danylipsker/HIGH-RATIO-GEAR-SET/output/ratio-500_m1_planet32/design_report.md

# Gear set design report - target ratio 500:1

Generated by `gearset.py --ratio 500 --planet 32 --aw-max 32 --delta-max 5 --ecc-min 8 --max-wall 20 --out /home/user/high-ratio-gear-set/output/ratio-500_m1_planet32`

## Result

| | |
|---|---|
| Exact ratio input : output | **-500** (output turns opposite to the input) |
| Module | 1.0 mm |
| Pressure angle | 20.0 deg |
| Sun Zs (input) | 20 |
| Planet Zp (one planet, on a free carrier) | 32 |
| Thin ring, internal teeth Zr1 | 135 |
| Thin ring, external teeth Zr2 | 153 |
| Fixed ring Zf (housing) | 204 (x = +0.0000) |
| Output ring Zo | 200 (x = +2.5097) |
| Profile-shifted ring | output ring, working pressure angle 30.00 deg |
| Sun-planet centre distance a1 | 26.0000 mm |
| Thin ring eccentricity e (centre at x = -e) | 25.5000 mm |
| Thin ring wall between tooth roots | 6.500 mm |
| Ring outer diameter | 217.52 mm |
| Face width per section / gap / total length | 10.0 / 2.0 / 22.0 mm (+ shaft stubs) |
| Backlash per mesh | 0.0 mm |

## How the ratio arises

All centres are fixed in the carrier frame, so Willis' method applies mesh by mesh:

```
carrier speed      wc = ws * Zs*Zr2 / (Zf*Zr1 + Zs*Zr2)
thin ring speed    wt = wc * (Zr2 - Zf) / Zr2          (rolls inside the fixed ring)
output ring speed  wo = wc * (Zo - Zf) / Zo
ratio              i  = ws / wo = Zo*(Zf*Zr1 + Zs*Zr2) / (Zs*Zr2*(Zo - Zf))
                      = 200*(204*135 + 20*153) / (20*153*(200 - 204)) = -500
```
The fixed ring is required: without a grounded ring the mechanism has two degrees of freedom and the
output ring would not be driven. The output ring differs from the fixed ring by 4 teeth and meshes with the same external teeth of the thin ring, which is why it is profile shifted.

Independent numeric check (pitch-point velocities in the fixed frame, sun speed = 1):

```
   carrier:  0.100000000
    planet: -0.462500000
 thin_ring: -0.033333333
    output: -0.002000000
     ratio: -500.000000000
formula   : -500.000000000   difference 6.82e-13
```
## Geometry of every toothed outline (mm)

| gear | type | Z | x | reference r | base rb | tip ra | root rf | root fillet | first tooth centre (deg) |
|---|---|---|---|---|---|---|---|---|---|
| sun | external | 20 | +0.0000 | 10.0000 | 9.3969 | 11.0000 | 8.7500 | 0.300 | 0.0000 |
| planet | external | 32 | +0.0000 | 16.0000 | 15.0351 | 17.0000 | 14.7500 | 0.240 | 5.6250 |
| thin_ring_internal | internal | 135 | +0.0000 | 67.5000 | 63.4293 | 66.5000 | 68.7500 | 0.300 | 0.0000 |
| thin_ring_external | external | 153 | +0.0000 | 76.5000 | 71.8865 | 77.5000 | 75.2500 | 0.300 | 0.0000 |
| fixed_ring | internal | 204 | +0.0000 | 102.0000 | 95.8486 | 101.0000 | 103.2500 | 0.300 | 0.0000 |
| output_ring | internal | 200 | +2.5097 | 100.0000 | 93.9693 | 101.5097 | 103.7597 | 0.240 | 1.8000 |

Positions in the assembly (mm): sun at (0,0), planet at (26.0000, 0), thin ring centre at (-25.5000, 0), fixed and output rings concentric with the sun. The sun/planet/thin-ring meshes lie on the +x axis, the thin-ring/fixed-ring and thin-ring/output-ring meshes on the -x axis. The outlines are already rotated (phases above) so that all teeth mesh at these positions.

## Mesh checks

| mesh | transverse contact ratio |
|---|---|
| sun/planet | 1.612 |
| planet/thin ring internal | 1.888 |
| thin ring external/fixed ring | 1.977 |
| thin ring external/output ring | 1.124 |

Radial clearances on the line of centres: fixed ring tip/thin ring root 0.250 mm, fixed ring root/thin ring tip 0.250 mm, output ring tip/thin ring root 0.760 mm, output ring root/thin ring tip 0.760 mm.

Rolling check (every gear rotated through two sun pitches in the carrier frame, worst penetration of
one tooth outline into the mating one; negative = minimum clearance, positive = collision):

| mesh | worst penetration (mm) |
|---|---|
| sun/planet | -0.0001 |
| planet/thin ring internal | +0.0003 |
| thin ring external/fixed ring | +0.0004 |
| thin ring external/output ring | +0.0001 |

## Axial layout

```
z = 0 .. 10   section A : sun, planet, thin ring internal teeth, FIXED ring
z = 12 .. 22   section B : carrier journal (in the thin ring bore), OUTPUT ring
thin ring external teeth run the full length 0 .. 22
carrier journal radius 68.650 centred at (-25.500, 0), bore for the sun shaft at (0,0), planet pin at (26.000, 0)
```
## Other exact solutions found

| score | Zs | Zp | Zr1 | Zr2 | Zf | Zo | shifted | alpha_w | ratio | ring OD at this module |
|---|---|---|---|---|---|---|---|---|---|---|
| 24.6 | 20 | 32 | 135 | 153 | 204 | 200 | output | 30.0 | -500 | 221.5 |

Re-run with `--set Zs Zp Zr1 Zr2 Zf Zo` to build any row, or `--sun/--planet` to pin tooth counts.
