danylipsker/HIGH-RATIO-GEAR-SET/output/ratio-500_m1_sun16/design_report.md

# Gear set design report - target ratio 500:1

Generated by `gearset.py --ratio 500 --sun 16 --out /home/user/high-ratio-gear-set/output/ratio-500_m1_sun16`

## Result

| | |
|---|---|
| Exact ratio input : output | **-500** (output turns opposite to the input) |
| Module | 1.0 mm |
| Pressure angle | 20.0 deg |
| Sun Zs (input) | 16 |
| Planet Zp (one planet, on a free carrier) | 18 |
| Thin ring, internal teeth Zr1 | 96 |
| Thin ring, external teeth Zr2 | 123 |
| Fixed ring Zf (housing) | 167 (x = +0.0000) |
| Output ring Zo | 164 (x = +1.8376) |
| Profile-shifted ring | output ring, working pressure angle 28.88 deg |
| Sun-planet centre distance a1 | 17.0000 mm |
| Thin ring eccentricity e (centre at x = -e) | 22.0000 mm |
| Thin ring wall between tooth roots | 11.000 mm |
| Ring outer diameter | 180.18 mm |
| Face width per section / gap / total length | 10.0 / 2.0 / 22.0 mm (+ shaft stubs) |
| Backlash per mesh | 0.0 mm |

## How the ratio arises

All centres are fixed in the carrier frame, so Willis' method applies mesh by mesh:

```
carrier speed      wc = ws * Zs*Zr2 / (Zf*Zr1 + Zs*Zr2)
thin ring speed    wt = wc * (Zr2 - Zf) / Zr2          (rolls inside the fixed ring)
output ring speed  wo = wc * (Zo - Zf) / Zo
ratio              i  = ws / wo = Zo*(Zf*Zr1 + Zs*Zr2) / (Zs*Zr2*(Zo - Zf))
                      = 164*(167*96 + 16*123) / (16*123*(164 - 167)) = -500
```
The fixed ring is required: without a grounded ring the mechanism has two degrees of freedom and the
output ring would not be driven. The output ring differs from the fixed ring by 3 teeth and meshes with the same external teeth of the thin ring, which is why it is profile shifted.

Independent numeric check (pitch-point velocities in the fixed frame, sun speed = 1):

```
   carrier:  0.109333333
    planet: -0.682370370
 thin_ring: -0.039111111
    output: -0.002000000
     ratio: -500.000000000
formula   : -500.000000000   difference 5.12e-13
```
## Geometry of every toothed outline (mm)

| gear | type | Z | x | reference r | base rb | tip ra | root rf | root fillet | first tooth centre (deg) |
|---|---|---|---|---|---|---|---|---|---|
| sun | external | 16 | +0.0000 | 8.0000 | 7.5175 | 9.0000 | 6.7500 | 0.300 | 0.0000 |
| planet | external | 18 | +0.0000 | 9.0000 | 8.4572 | 10.0000 | 7.7500 | 0.300 | 10.0000 |
| thin_ring_internal | internal | 96 | +0.0000 | 48.0000 | 45.1052 | 47.0862 | 49.2500 | 0.300 | 0.0000 |
| thin_ring_external | external | 123 | +0.0000 | 61.5000 | 57.7911 | 62.5000 | 60.2500 | 0.300 | 0.0000 |
| fixed_ring | internal | 167 | +0.0000 | 83.5000 | 78.4643 | 82.5000 | 84.7500 | 0.300 | 1.0778 |
| output_ring | internal | 164 | +1.8376 | 82.0000 | 77.0548 | 82.8376 | 85.0876 | 0.300 | 2.1951 |

Positions in the assembly (mm): sun at (0,0), planet at (17.0000, 0), thin ring centre at (-22.0000, 0), fixed and output rings concentric with the sun. The sun/planet/thin-ring meshes lie on the +x axis, the thin-ring/fixed-ring and thin-ring/output-ring meshes on the -x axis. The outlines are already rotated (phases above) so that all teeth mesh at these positions.

## Mesh checks

| mesh | transverse contact ratio |
|---|---|
| sun/planet | 1.514 |
| planet/thin ring internal | 1.748 |
| thin ring external/fixed ring | 1.977 |
| thin ring external/output ring | 1.361 |

Radial clearances on the line of centres: fixed ring tip/thin ring root 0.250 mm, fixed ring root/thin ring tip 0.250 mm, output ring tip/thin ring root 0.588 mm, output ring root/thin ring tip 0.588 mm.

Rolling check (every gear rotated through two sun pitches in the carrier frame, worst penetration of
one tooth outline into the mating one; negative = minimum clearance, positive = collision):

| mesh | worst penetration (mm) |
|---|---|
| sun/planet | -0.0000 |
| planet/thin ring internal | +0.0004 |
| thin ring external/fixed ring | +0.0005 |
| thin ring external/output ring | +0.0002 |

**Warnings**

- thin_ring_internal: tip shortened by 0.086 mm - it reached 0.036 mm past the base-tangent point of the planet (involute interference); contact ratio recomputed with the shorter tip

## Axial layout

```
z = 0 .. 10   section A : sun, planet, thin ring internal teeth, FIXED ring
z = 12 .. 22   section B : carrier journal (in the thin ring bore), OUTPUT ring
thin ring external teeth run the full length 0 .. 22
carrier journal radius 49.150 centred at (-22.000, 0), bore for the sun shaft at (0,0), planet pin at (17.000, 0)
```
## Other exact solutions found

| score | Zs | Zp | Zr1 | Zr2 | Zf | Zo | shifted | alpha_w | ratio | ring OD at this module |
|---|---|---|---|---|---|---|---|---|---|---|
| 18.1 | 16 | 18 | 96 | 123 | 167 | 164 | output | 28.9 | -500 | 183.2 |

Re-run with `--set Zs Zp Zr1 Zr2 Zf Zo` to build any row, or `--sun/--planet` to pin tooth counts.
