danylipsker/HIGH-RATIO-GEAR-SET/output/ratio-500_m1/design_report.md

# Gear set design report - target ratio 500:1

Generated by `gearset.py --ratio 500 --out /home/user/high-ratio-gear-set/output/ratio-500_m1`

## Result

| | |
|---|---|
| Exact ratio input : output | **-500** (output turns opposite to the input) |
| Module | 1.0 mm |
| Pressure angle | 20.0 deg |
| Sun Zs (input) | 24 |
| Planet Zp (one planet, on a free carrier) | 20 |
| Thin ring, internal teeth Zr1 | 102 |
| Thin ring, external teeth Zr2 | 114 |
| Fixed ring Zf (housing) | 152 (x = +0.0000) |
| Output ring Zo | 150 (x = +1.1782) |
| Profile-shifted ring | output ring, working pressure angle 27.10 deg |
| Sun-planet centre distance a1 | 22.0000 mm |
| Thin ring eccentricity e (centre at x = -e) | 19.0000 mm |
| Thin ring wall between tooth roots | 3.500 mm |
| Ring outer diameter | 164.86 mm |
| Face width per section / gap / total length | 10.0 / 2.0 / 22.0 mm (+ shaft stubs) |
| Backlash per mesh | 0.0 mm |

## How the ratio arises

All centres are fixed in the carrier frame, so Willis' method applies mesh by mesh:

```
carrier speed      wc = ws * Zs*Zr2 / (Zf*Zr1 + Zs*Zr2)
thin ring speed    wt = wc * (Zr2 - Zf) / Zr2          (rolls inside the fixed ring)
output ring speed  wo = wc * (Zo - Zf) / Zo
ratio              i  = ws / wo = Zo*(Zf*Zr1 + Zs*Zr2) / (Zs*Zr2*(Zo - Zf))
                      = 150*(152*102 + 24*114) / (24*114*(150 - 152)) = -500
```
The fixed ring is required: without a grounded ring the mechanism has two degrees of freedom and the
output ring would not be driven. The output ring differs from the fixed ring by 2 teeth and meshes with the same external teeth of the thin ring, which is why it is profile shifted.

Independent numeric check (pitch-point velocities in the fixed frame, sun speed = 1):

```
   carrier:  0.150000000
    planet: -0.870000000
 thin_ring: -0.050000000
    output: -0.002000000
     ratio: -500.000000000
formula   : -500.000000000   difference 1.14e-13
```
## Geometry of every toothed outline (mm)

| gear | type | Z | x | reference r | base rb | tip ra | root rf | root fillet | first tooth centre (deg) |
|---|---|---|---|---|---|---|---|---|---|
| sun | external | 24 | +0.0000 | 12.0000 | 11.2763 | 13.0000 | 10.7500 | 0.300 | 0.0000 |
| planet | external | 20 | +0.0000 | 10.0000 | 9.3969 | 11.0000 | 8.7500 | 0.300 | 9.0000 |
| thin_ring_internal | internal | 102 | +0.0000 | 51.0000 | 47.9243 | 50.0000 | 52.2500 | 0.300 | 0.0000 |
| thin_ring_external | external | 114 | +0.0000 | 57.0000 | 53.5625 | 58.0000 | 55.7500 | 0.300 | 0.0000 |
| fixed_ring | internal | 152 | +0.0000 | 76.0000 | 71.4166 | 75.0000 | 77.2500 | 0.300 | 1.1842 |
| output_ring | internal | 150 | +1.1782 | 75.0000 | 70.4769 | 75.1782 | 77.4282 | 0.300 | 1.2000 |

Positions in the assembly (mm): sun at (0,0), planet at (22.0000, 0), thin ring centre at (-19.0000, 0), fixed and output rings concentric with the sun. The sun/planet/thin-ring meshes lie on the +x axis, the thin-ring/fixed-ring and thin-ring/output-ring meshes on the -x axis. The outlines are already rotated (phases above) so that all teeth mesh at these positions.

## Mesh checks

| mesh | transverse contact ratio |
|---|---|
| sun/planet | 1.579 |
| planet/thin ring internal | 1.858 |
| thin ring external/fixed ring | 1.979 |
| thin ring external/output ring | 1.604 |

Radial clearances on the line of centres: fixed ring tip/thin ring root 0.250 mm, fixed ring root/thin ring tip 0.250 mm, output ring tip/thin ring root 0.428 mm, output ring root/thin ring tip 0.428 mm.

Rolling check (every gear rotated through two sun pitches in the carrier frame, worst penetration of
one tooth outline into the mating one; negative = minimum clearance, positive = collision):

| mesh | worst penetration (mm) |
|---|---|
| sun/planet | -0.0002 |
| planet/thin ring internal | +0.0004 |
| thin ring external/fixed ring | +0.0007 |
| thin ring external/output ring | +0.0002 |

## Axial layout

```
z = 0 .. 10   section A : sun, planet, thin ring internal teeth, FIXED ring
z = 12 .. 22   section B : carrier journal (in the thin ring bore), OUTPUT ring
thin ring external teeth run the full length 0 .. 22
carrier journal radius 52.150 centred at (-19.000, 0), bore for the sun shaft at (0,0), planet pin at (22.000, 0)
```
## Other exact solutions found

| score | Zs | Zp | Zr1 | Zr2 | Zf | Zo | shifted | alpha_w | ratio | ring OD at this module |
|---|---|---|---|---|---|---|---|---|---|---|
| 15.5 | 24 | 20 | 102 | 114 | 152 | 150 | output | 27.1 | -500 | 166.9 |
| 17.2 | 18 | 23 | 108 | 123 | 167 | 164 | output | 28.9 | -500 | 183.2 |
| 17.6 | 17 | 25 | 90 | 115 | 138 | 136 | output | 30.9 | -500 | 153.1 |
| 17.6 | 24 | 19 | 98 | 126 | 162 | 160 | output | 27.4 | -500 | 176.9 |
| 18.1 | 16 | 18 | 96 | 123 | 167 | 164 | output | 28.9 | -500 | 183.2 |
| 18.7 | 27 | 18 | 105 | 120 | 162 | 160 | output | 26.5 | -500 | 176.8 |
| 19.2 | 20 | 16 | 66 | 91 | 105 | 104 | output | 29.2 | -500 | 118.7 |
| 19.5 | 18 | 17 | 64 | 88 | 99 | 100 | fixed | 30.5 | 500 | 112.8 |
| 19.5 | 20 | 13 | 85 | 111 | 148 | 150 | fixed | 26.9 | 500 | 162.8 |
| 19.8 | 27 | 23 | 108 | 132 | 167 | 165 | output | 27.6 | -500 | 181.9 |
| 20.5 | 24 | 27 | 105 | 135 | 162 | 160 | output | 29.5 | -500 | 177.0 |
| 20.8 | 28 | 15 | 76 | 102 | 119 | 120 | fixed | 27.4 | 500 | 132.7 |

Re-run with `--set Zs Zp Zr1 Zr2 Zf Zo` to build any row, or `--sun/--planet` to pin tooth counts.
