danylipsker/HIGH-RATIO-GEAR-SET/output/ratio-528.7_m1.25_thin_ring/design_report.md

# Gear set design report - target ratio 1560695/2952:1

Generated by `gearset.py --ratio 1560695/2952 --set 16 32 115 123 158 155 --module 1.25 --out /home/user/high-ratio-gear-set/output/ratio-528.7_m1.25_thin_ring`

## Result

| | |
|---|---|
| Exact ratio input : output | **-1560695/2952 = -528.690718** (output turns opposite to the input) |
| Module | 1.25 mm |
| Pressure angle | 20.0 deg |
| Sun Zs (input) | 16 |
| Planet Zp (one planet, on a free carrier) | 32 |
| Thin ring, internal teeth Zr1 | 115 |
| Thin ring, external teeth Zr2 | 123 |
| Fixed ring Zf (housing) | 158 (x = +0.0000) |
| Output ring Zo | 155 (x = +1.9133) |
| Profile-shifted ring | output ring, working pressure angle 30.78 deg |
| Sun-planet centre distance a1 | 30.0000 mm |
| Thin ring eccentricity e (centre at x = -e) | 21.8750 mm |
| Thin ring wall between tooth roots | 1.875 mm |
| Ring outer diameter | 214.16 mm |
| Face width per section / gap / total length | 12.5 / 2.0 / 27.0 mm (+ shaft stubs) |
| Backlash per mesh | 0.0 mm |

## How the ratio arises

All centres are fixed in the carrier frame, so Willis' method applies mesh by mesh:

```
carrier speed      wc = ws * Zs*Zr2 / (Zf*Zr1 + Zs*Zr2)
thin ring speed    wt = wc * (Zr2 - Zf) / Zr2          (rolls inside the fixed ring)
output ring speed  wo = wc * (Zo - Zf) / Zo
ratio              i  = ws / wo = Zo*(Zf*Zr1 + Zs*Zr2) / (Zs*Zr2*(Zo - Zf))
                      = 155*(158*115 + 16*123) / (16*123*(155 - 158)) = -1560695/2952 = -528.690718
```
The fixed ring is required: without a grounded ring the mechanism has two degrees of freedom and the
output ring would not be driven. The output ring differs from the fixed ring by 3 teeth and meshes with the same external teeth of the thin ring, which is why it is profile shifted.

Independent numeric check (pitch-point velocities in the fixed frame, sun speed = 1):

```
   carrier:  0.097725693
    planet: -0.353411461
 thin_ring: -0.027808124
    output: -0.001891465
     ratio: -528.690718157
formula   : -528.690718157   difference 1.14e-12
```
## Geometry of every toothed outline (mm)

| gear | type | Z | x | reference r | base rb | tip ra | root rf | root fillet | first tooth centre (deg) |
|---|---|---|---|---|---|---|---|---|---|
| sun | external | 16 | +0.0000 | 10.0000 | 9.3969 | 11.2500 | 8.4375 | 0.375 | 0.0000 |
| planet | external | 32 | +0.0000 | 20.0000 | 18.7939 | 21.2500 | 18.4375 | 0.300 | 5.6250 |
| thin_ring_internal | internal | 115 | +0.0000 | 71.8750 | 67.5404 | 70.6250 | 73.4375 | 0.375 | 0.0000 |
| thin_ring_external | external | 123 | +0.0000 | 76.8750 | 72.2389 | 78.1250 | 75.3125 | 0.375 | 0.0000 |
| fixed_ring | internal | 158 | +0.0000 | 98.7500 | 92.7946 | 97.5000 | 100.3125 | 0.375 | -0.0000 |
| output_ring | internal | 155 | +1.9133 | 96.8750 | 91.0327 | 98.0166 | 100.8291 | 0.300 | 1.1613 |

Positions in the assembly (mm): sun at (0,0), planet at (30.0000, 0), thin ring centre at (-21.8750, 0), fixed and output rings concentric with the sun. The sun/planet/thin-ring meshes lie on the +x axis, the thin-ring/fixed-ring and thin-ring/output-ring meshes on the -x axis. The outlines are already rotated (phases above) so that all teeth mesh at these positions.

## Mesh checks

| mesh | transverse contact ratio |
|---|---|
| sun/planet | 1.583 |
| planet/thin ring internal | 1.901 |
| thin ring external/fixed ring | 1.981 |
| thin ring external/output ring | 1.249 |

Radial clearances on the line of centres: fixed ring tip/thin ring root 0.312 mm, fixed ring root/thin ring tip 0.312 mm, output ring tip/thin ring root 0.829 mm, output ring root/thin ring tip 0.829 mm.

Rolling check (every gear rotated through two sun pitches in the carrier frame, worst penetration of
one tooth outline into the mating one; negative = minimum clearance, positive = collision):

| mesh | worst penetration (mm) |
|---|---|
| sun/planet | -0.0000 |
| planet/thin ring internal | +0.0005 |
| thin ring external/fixed ring | +0.0009 |
| thin ring external/output ring | +0.0002 |

## Axial layout

```
z = 0 .. 12.5   section A : sun, planet, thin ring internal teeth, FIXED ring
z = 14.5 .. 27   section B : carrier journal (in the thin ring bore), OUTPUT ring
thin ring external teeth run the full length 0 .. 27
carrier journal radius 73.325 centred at (-21.875, 0), bore for the sun shaft at (0,0), planet pin at (30.000, 0)
```
## Other exact solutions found

| score | Zs | Zp | Zr1 | Zr2 | Zf | Zo | shifted | alpha_w | ratio | ring OD at this module |
|---|---|---|---|---|---|---|---|---|---|---|
| 0.0 | 16 | 32 | 115 | 123 | 158 | 155 | output | 30.8 | -1560695/2952 = -528.690718 | 217.9 |

Re-run with `--set Zs Zp Zr1 Zr2 Zf Zo` to build any row, or `--sun/--planet` to pin tooth counts.
