danylipsker/HIGH-RATIO-GEAR-SET/SESSION-2026-10-25c.md

# Session 2026-10-25 (c): mates for an imported assembly

GEARS GENERATOR now has the set as a family card (its engine builds the six gears, the housing
and the bearings from `gearset.py`'s geometry and writes one STEP). SolidWorks opens that STEP
as an assembly of fixed components with generic names, so `GearBuilder.cs` gained
`MateImportedAssembly(IModelDoc2 asmDoc, GearModel g)`:

- tells the six gears apart by their bounding boxes against the layout (sun: shaft from -2b to
  beyond section B; planet about +a1; thin ring about -e over both sections; carrier; fixed ring
  in section A; output ring in section B, or the output cup to the end of its shaft with a
  housing), each name to its best unused component, rejected when off by more than 2 mm + 10 %;
- keeps the fixed ring fixed, frees the other five, and adds the same mates as `Build`
  (`AddMates`): Front Planes coincident with the fixed ring's, concentric per moving part, gear
  mates to the sun with ks, kp, kt, ko;
- reports every step in `BuildResult.MateReport` and the component boxes in `Log`.

The stubs (`solidworks/stubs/sldworks.cs`) learnt `GetComponents`, `UnfixComponent`,
`Component2.GetBox` and `IsFixed`; `compile_check.sh` passes. The copy in GEARS GENERATOR
(`src/GearGen.SolidWorksAddin/HighRatio/GearBuilder.cs`) is this file unchanged; its
`SwAddin.InsertCore` calls the method after the STEP import. The standalone add-in's own build
is unchanged (it mates the parts it makes, as before).

## Motion Study

`GearBuilder.AddMotionStudy` (after the mates, both in `Build` and in `MateImportedAssembly`):
`IModelDocExtension.GetMotionStudyManager` → `CreateMotionStudy` named "Sun drive", `Activate`,
`SetDuration(10 s)`, the sun's input stub face (the one the mates use) pre-selected with mark 0,
`CreateMotor(swRotaryMotor, swMotorConstantSpeed, 60 rpm)`: 10 sun turns, 7.2° on the output ring
of the 1:500 set. The swmotionstudy interop is driven late-bound through `dynamic` (the add-in
references no further assembly; `compile_check.sh` now adds Microsoft.CSharp); the enum values are
read from the installed `SolidWorks.Interop.swmotionstudy.dll` (next to SLDWORKS.exe, in
api\redist, or the GAC), else the documented 1 / 1. `BuildResult.MotionStudy` carries the line
the message boxes show; every failure is reported in `MateReport` and the log, never thrown.
Flags: `GearBuilder.AddMotor`, `MotorRpm`, `MotorSeconds`.

## The dialog, in the user's order

`GearSetForm.cs` rebuilt around the way Dany works: **1 module, 2 gear ratio, 3 Find solutions**
on one line; **4 the table** of every tooth set that gives the ratio (best first, now with a
Sense column and the overall length); **5 the picked solution** -- the title names the row,
the dimensions, the folder name and Build follow it. The search range (sun and planet ranges,
forced counts), the design rules (ring tooth difference, max working pressure angle, max ring
OD), face width / backlash / root fillet, an exact tooth set and the presets are under an
"Advanced" check box, folded.

Found on the way: with the default rules this mechanism's smallest ratio is about **1:216**
(sun up to 30); 1:200 needs a 35-tooth sun (35/10/91/99/135/132), 1:100 is out of reach even
with a 60-tooth sun. The old dialog answered 1:100 with "nearest" rows 428 % off; the new one
lists nearest rows only within 15 % and otherwise says what the mechanism reaches and that a
planetary or compound planetary set is the right choice below about 1:200.

## The dialog once more: the table first, a blank start, 75:1

Asked next: "all the gears teeth etc. reset to 0; the main table on the top; the user types the
module and the gear ratio and clicks Find solutions; the rest follows the table; for 75:1 fill
the table with the possible rows." `GearSetForm.cs` now opens with the **empty table on top**
(its hint says what to do), then the line **1 module, 2 gear ratio, 3 Find solutions** (both
boxes blank, nothing remembered, nothing searched until asked), then **4 the picked solution**:
dimensions, folder, Build. Advanced is folded at the bottom.

The search is staged and runs off the UI thread (`StagedSearch` in a Task, the result shown on
the UI thread): exact sets in the range as typed; failing that, exact sets in a widened range
(sun to 60, planet from 10, rings up to 6 teeth apart, eccentric difference up to 100); failing
that, the nearest ratios in the widened range, closest first, each row's error in its Note. So
1:75 fills the table -- with the sets nearest to it, the closest being about 1:165 -- and the
status says that ratios under about 1:165 are below what a 3K floating-ring set can do and
that a planetary or compound planetary set is the right choice there. Measured with
gearset.py's solver: the widened nearest search for 75, 100 and 150 all land on
60/10/137/145/202/197 = -164.7 first (alpha_w at the 31 degree limit).

## 2026-10-27: the trailing root fillets were drawn the long way round

Dany's sketch showed a fillet as a 270 degree loop between a flank and the radial line. Cause,
in `GearMath.FilletSeg(mirror: true)` and in gearset.py's `fillet_seg(mirror=True)` alike: the
mirrored fillet segment is reflected across the tooth centre line AND listed backwards (T1 -> T2),
and the two reversals cancel, so the turning sense in the segment's own order is the original
one -- the code flipped it. SolidWorks' `CreateArc` and the DXF `ARC` (always counter-clockwise
from start to end angle) then took the long way: every trailing fillet of every gear a near
full circle, the leading ones right. The sampled polylines (rolling check, STL, the family path's
solids) never used the flag, which is why the numbers and the family-path builds were clean.

Fixed in both languages; measured on the default set with a small harness: all twelve fillet
arcs now sweep 66..88 degrees (before: the trailing six 272..294). `output/*` regenerated with
`build_all.py`; the DXF fillet arcs of the default set all under 90 degrees. Copies in GEARS
GENERATOR updated (`HighRatio\GearMath.cs`, `py/gear_step/high_ratio_core.py`).

Verified on Dany's SolidWorks 2020 (2026-10-27): the fillets blend, the set built.

## 2026-10-27: the flank spline doubled the radial line

Dany's next sketch (a sun or planet root, zoomed): a straight line alongside the lower end of
the flank spline, both from the fillet's end to the base circle. Cause, in both languages: with
a fillet AND a radial line between it and the base circle (external gears with rb > rf), the
flank's first point was still moved down to the fillet's end T1, so the spline ran from T1 up
through the base circle, over the radial line T1 -> rb. Now the flank starts at the base circle
when a radial line precedes it, and at T1 only when the fillet meets the involute itself
(rb <= rf). Checked with a harness over six sets, every gear: no gaps between segments, no
zero-length lines, no repeated or reversing spline points, every flank after a radial line
starting at rb, every fillet arc short, tooth 0 meeting tooth 1. The C# and Python outlines
agree point for point as before.

Verified on Dany's SolidWorks 2020 (2026-10-27): the doubled line at the base circle is gone, the set built.

Interference Detection on the set built after both fixes (Dany's SolidWorks 2020, 2026-10-27): zero
interferences. The rolling check of the regenerated report is unchanged (sub-micron, zero backlash).

Noted for next time: in the assembly with the part sketches shown, the thin ring's external flank
and the fixed ring's flank near the contact point look like a doubled line (a zero-backlash internal
mesh, relative curvature radius about 78 mm: a few microns apart over a millimetre of flank). Two
parts, nothing redundant; hide the sketches (View > Hide/Show > Sketches) or build with backlash.

Thin ring set 16/32/115/123/158/155 built after the fixes (Dany's SolidWorks 2020, 2026-10-27): zero
interferences, Motion Study 10 sun turns = 6.81 deg on the output ring (1:528.69).

## 2026-10-27: involute (tip) interference on the sun-16 set

Asked to check the 1:500 sun-16 preset (16/18/96/123/167/164). Its report showed +0.002 mm on the
planet / thin ring internal mesh where the other sets show noise; at three times finer flank
sampling the noise went to zero and this one stayed, and at 96 phase steps instead of 24 it grew
to **+0.040 mm**: the thin ring's internal tooth tips (ra 47.000) reach 0.036 mm past the planet's
base-tangent point on the line of action (sqrt(rb_ring^2 + (a sin alpha)^2) = 47.036), so at some
phases they dig into the 18-tooth planet's flank below its base circle. Classic involute
interference of an internal gear with a small pinion; SolidWorks' static check cannot see it and
the 24-step rolling check happened to miss the phase.

Fix in both languages, in the model build: for every mesh, the tip that passes the mate's
base-tangent point is taken back by the overshoot plus 0.05 m (`GearGeom(tip_shorten=...)` /
`TipClear`), noted ("tip shortened by 0.086 mm ..."), contact ratio recomputed. External pairs:
either tip; internal pairs: only the ring's tip can offend (the pinion's tip contact always lies
on the valid side). `verify_meshing` now steps 72 times (was 24). Measured at 96 steps and 48
flank points: zero penetration on all four meshes of six sets; shortening applied on sun-16
(thin ring internal 0.086 mm, contact ratio 1.85 -> 1.75), on 28/13/78/88/112/110 (sun 0.143,
thin ring internal 0.347 mm, a 13-tooth planet) and 13/21/104/112/161/160 (planet 0.097 mm);
none on the default, thin-ring and planet-32 sets, whose profiles are unchanged. C# and Python
outlines agree to 1e-13 mm on the sun-16 set with the shortened tip.

Sun-16 set rebuilt with the shortened thin-ring tips (Dany's SolidWorks 2020, 2026-10-27): zero
interferences, Motion Study 10 sun turns = 7.2 deg on the output ring.

Planet-32 set 20/32/135/153/204/200 built after the fixes (Dany's SolidWorks 2020, 2026-10-27): zero
interferences, Motion Study 10 sun turns = 7.2 deg. All four presets of the dialog are now verified
on the corrected generators.

Default set with 0.05 mm backlash built (Dany's SolidWorks 2020, 2026-10-27): zero interferences, the
dead band visible when the sun reverses, Motion Study 10 sun turns = 7.2 deg.

Thin ring set at module 2 built (Dany's SolidWorks 2020, 2026-10-27): zero interferences, Motion Study
10 sun turns = 6.81 deg. Module scaling verified in SolidWorks as well as numerically.

Sun-16 set at module 1.5 built (thin ring internal tips shortened by 0.129 mm; Dany's SolidWorks 2020,
2026-10-27): zero interferences, Motion Study 10 sun turns = 7.2 deg.

Planet-32 set at module 1.25 built (Dany's SolidWorks 2020, 2026-10-27): zero interferences, Motion
Study 10 sun turns = 7.2 deg.

Default set at module 2 built (Dany's SolidWorks 2020, 2026-10-27): zero interferences, Motion Study
10 sun turns = 7.2 deg. Nine builds verified today across the four presets, modules 1 to 2 and backlash.

Thin ring set at module 1.5 built (Dany's SolidWorks 2020, 2026-10-27): zero interferences, Motion
Study 10 sun turns = 6.81 deg.

Planet-32 set at module 2 built (435 mm ring; Dany's SolidWorks 2020, 2026-10-27): zero interferences,
Motion Study 10 sun turns = 7.2 deg.

Sun-16 set at module 2 built (thin ring internal tips shortened by 0.172 mm; Dany's SolidWorks 2020,
2026-10-27): zero interferences, Motion Study 10 sun turns = 7.2 deg. Every preset is now verified at
module 1 and at module 2.

Default set at module 1.5 built (Dany's SolidWorks 2020, 2026-10-27): zero interferences, Motion Study
10 sun turns = 7.2 deg. Thirteen builds verified today.

Thin ring set at module 1.25 built (Dany's SolidWorks 2020, 2026-10-27): zero interferences, Motion
Study 10 sun turns = 6.81 deg. The thin ring set is now verified at all four of its preset modules.

Sun-16 set at module 1.25 built (thin ring internal tips shortened by 0.108 mm; Dany's SolidWorks 2020,
2026-10-27): zero interferences, Motion Study 10 sun turns = 7.2 deg. The sun-16 set is now verified at
modules 1, 1.25, 1.5 and 2, the tip shortening scaling with each.

## 2026-10-27 (desktop): the bearings are catalogue parts

Dany: "When adding ball bearings you can use the folder and the file attached ... plenty of pre configured
bearings made according to real life standards and dimensions. If you can, I prefer to use the attached
ones." The file: NSK "Minature Ball Bearings 600 Series.SLDPRT" (SolidWorks 2018), one part with 118
configurations named by designation (601 X .. 609 ZZ, 623 .. 639, 681 .. 699 with X / A / ZZ variants, MR 31 ..
MR 148), bore 1 to 9 mm, OD up to 30 mm, the bore axis Z, centred on the origin. Next to it, the GOST
8338-75 folder: one file per bearing, "Подшипник 100 .. 120" = 6000 .. 6020 and 16 / 17 / 18 = 606 / 607 / 608,
rings + balls + cage (26 to 38 bodies), the axis X, centred. The gear set's housing needs 6001 and 6008 at
module 1, which only the GOST folder has, so the library takes both.

`BearingLibrary` (GearBuilder.cs): the files named (';'-separated files and folders; HKCU
`Software\GearSetAddin\BearingLibrary`, else the two known folders when present) are opened once, read-only,
and every configuration measured: the short extent of the bounding box is the bore axis and the width, the
two equal extents the OD (a part that is not round about one axis and centred is skipped), the bore the
smallest cylindrical face on that axis through the origin (cage pockets are off-axis). Cached per file under
`%LOCALAPPDATA%\GearSetAddin\bearings` (size + time stamped), so the dialog and `GearSetCli solve` see the
same bearings without SolidWorks once scanned. `Bearing` gained File / Config / Axis / AxisOffset;
`HousingSpec.ForBore(bore, catalogue)` takes the smallest fitting bore and of those the part nearest the
60-series size (`Series60Small` 603 .. 609 for bores under 10, `Series60` above; open before ZZ);
`HousingSpec.Create` / `GearModel.AddHousing` take the catalogue. `GearBuilder.Build` scans the library,
re-lays the housing on its bearings, builds no plain ring for a catalogue bearing and inserts the part in
its configuration through `AddComponent5` (`ReferencedConfiguration` checked), with a `Transform2` that
turns the part's bore axis onto Z and puts its mid-width at the seat (row-vector rotation, the transposed
one tried when the box read back disagrees). `MateImportedAssembly` (the family path) deletes each imported
bearing solid whose box matches and puts the catalogue part of exactly the same bore / OD / width in its
place, fixed. `BuildResult.BearingReport` names every bearing, its source and the placed box; the dialog's
Advanced row "Bearings from catalogue parts", `GearSetCli build -bearings <paths>|none` and
`GearSetCli bearings [-paths] [-cached]`. Stubs extended (configurations, transforms, part box).

Verified on Dany's SolidWorks 2020 (2026-10-27): `GearSetCli bearings -new` measured all 140 (118 NSK + 22
GOST) in one pass, every bore / OD / width as in the catalogues (681 = 1 x 3 x 1, 608 = 8 x 22 x 7, 6001 =
12 x 28 x 8, 6008 = 40 x 68 x 15); the default 1:500 set built with the GOST 6001 and 6008 parts - ten files,
no Bearing*.SLDPRT, the three catalogue bearings placed on the sun axis at z -11..-3, 27.2..35.2 and
27.2..42.2 with their boxes as expected, 23 sketches checked, 14 mates; the family path's STEP of the same
set (GEARS GENERATOR `export_high_ratio_step`, housing on) imported as an assembly through a harness and
given `MateImportedAssembly`: the three imported bearing solids replaced by the same GOST parts, 14 mates.
GEARS GENERATOR carries the three files unchanged and passes its build. Not yet seen by eye: the balls and
cage of the GOST parts sitting in the housing seats (the seats are cut to the catalogue OD and width, so
only the chamfers differ from the plain rings).

Planet-32 set at module 1.5 built (Dany's SolidWorks 2020, 2026-10-27): zero interferences, Motion
Study 10 sun turns = 7.2 deg. Every preset is now verified at modules 1, 1.25, 1.5 and 2 (the default
set at 1, 1.5, 2 and with backlash): sixteen builds.

Default set at module 1.25 built (Dany's SolidWorks 2020, 2026-10-27): zero interferences, Motion Study
10 sun turns = 7.2 deg. The grid is complete: all four presets at modules 1, 1.25, 1.5 and 2, plus the
default set with 0.05 mm backlash -- seventeen builds, every one with zero interferences and the exact
ratio in motion, on the generators as fixed today.

## 2026-10-27: every profile sketch checked inside SolidWorks

Dany asked again about "redundant straight lines" on a picture of the thin ring / fixed ring
flanks in the assembly, and for a guarantee that every sketch is a continuous chain. The
generator emits no straight entity along a flank (the harnesses over seven sets: no entity
within half a micron of another, no doubling back), and the straight-looking entity in that
picture is the 158-tooth fixed ring's own flank spline, nearly straight, seen next to the thin
ring's in the assembly. To make the guarantee SolidWorks' own, `GearBuilder.VerifySketch` now
runs on every sketch before it is extruded: it asks the sketch for its segments and contours
(`ISketch.GetSketchSegments`, `GetSketchContours`, `ISketchContour.IsClosed`,
`ISketchSegment.GetType`) and compares with what `AddOutline` drew: the number of flank
splines, fillet arcs, root/tip arcs and straight lines (only the radial stretches below the
base circle of a small pinion; zero on every ring), and the contours: the tooth profile must be
ONE closed contour plus one per circle (bore, rim, holes), no open contour. One line per sketch
in `BuildResult.SketchReport` and the log; the message box says "Sketches: all N checked in
SolidWorks - each tooth profile one closed contour, no stray lines" or lists the problems.
Stubs: ISketch, ISketchContour, ISketchSegment.GetType, swSketchSegments_e.

Verified on Dany's SolidWorks 2020 (2026-10-27): the build message reports every profile sketch checked
in SolidWorks, each tooth profile one closed contour, no stray lines.

## 2026-10-27: every sketch fixed and fully defined

Asked: "every sketch must have constraints so the sketches do not move; if dimensioning is too
complicated, add a Fix constraint". `GearBuilder.FixSketch`, run after `VerifySketch` on every
sketch before it is extruded: selects every segment (`ISketchSegment.Select4`), adds the Fixed
relation to all of them at once (`IModelDoc2.SketchAddConstraints("sgFIXED")`) and reads back
`ISketch.GetConstrainedStatus`; "fixed N of N entities, fully defined" is appended to the sketch's
report line, anything else counts as a sketch problem. A dimension scheme for a thousand involute
splines would be unreadable, so the profile is held by its coordinates and the Fixed relations,
exactly as asked. Stubs: Select4 on segments, SketchAddConstraints, GetConstrainedStatus,
swConstrainedStatus_e.

Verified on Dany's SolidWorks 2020 (2026-10-27, desktop session): the default set built through
`GearSetCli build -ratio 500 -module 1 -new` (a hidden instance): 29 sketches checked, 0 problems, every
one "fixed N of N entities, fully defined" (fixed ring 919 entities, output ring 901, thin ring 685 + 613,
sun 192, planet 161, the plain circle sketches 1 to 8); all 14 mates ok.

## 2026-10-27 (desktop): the standalone add-in and the CLI compile against the real interop again

Neither had been built since the Motion Study commit. On the 2020 interop `Environment` is ambiguous
(`SolidWorks.Interop.sldworks` has an `Environment` interface) in `AddIn.cs` and in the CLI's `Program.cs`:
now `System.Environment`. The late-bound `dynamic` motion-study calls need a `Microsoft.CSharp` reference,
added to both .csproj files (the stub compile check already had it). `install.ps1 -BuildOnly` builds both
again. The CLI now prints the per-sketch report lines and the sketch summary after the mate lines.
Found on the way: in a hidden SolidWorks started by the CLI the Motion Study is not created
("CreateMotionStudy returned nothing" once, the study without its motor the next time); in a visible
SolidWorks it is (verified earlier). The standalone add-in is not registered on this machine any more
(`diagnose.ps1`: no COM class, no Addins keys); GEARS GENERATOR's add-in carries the same dialog and builder.
