danylipsker/HIGH-RATIO-GEAR-SET/output/ratio-500_m1/layout_sectionA.png

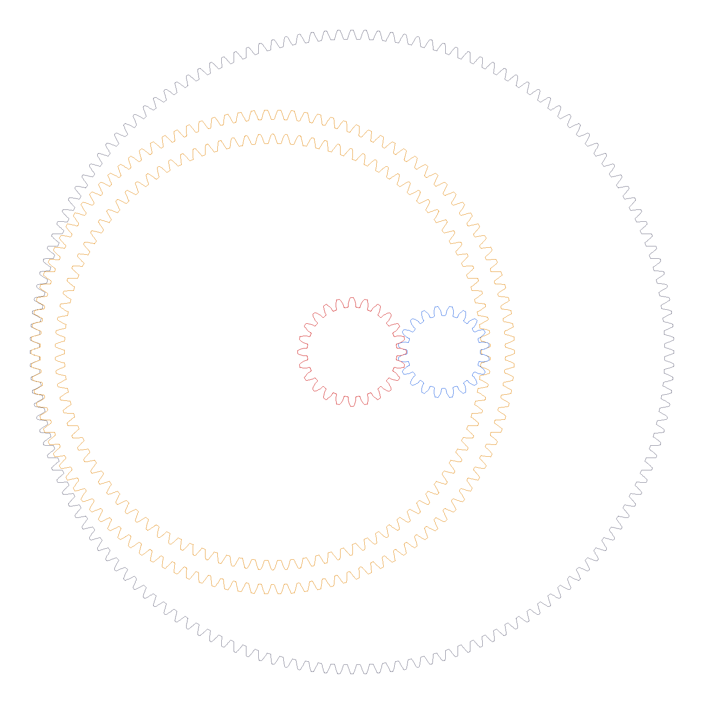
output/ratio-500_m1/layout_sectionA.png
