danylipsker/HIGH-RATIO-GEAR-SET/output/ratio-500_m1/layout_sectionB.png

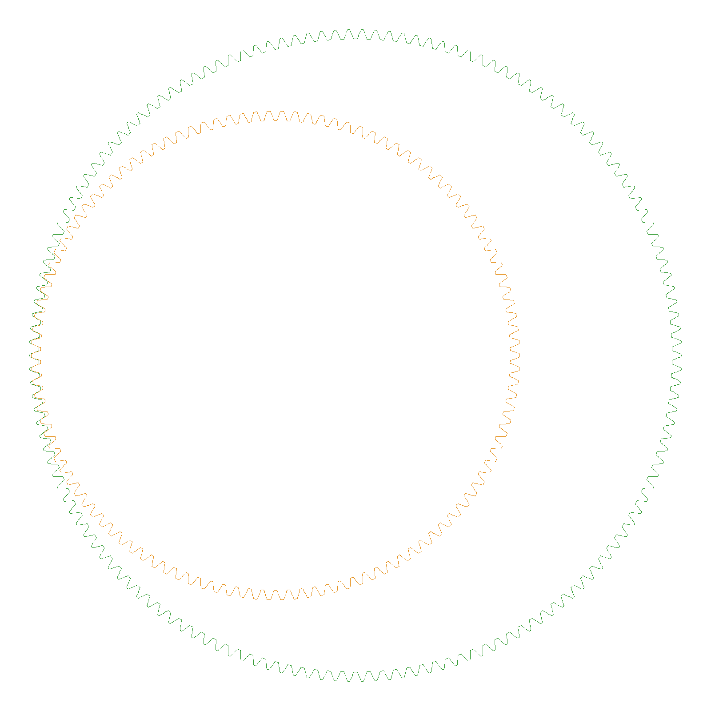
output/ratio-500_m1/layout_sectionB.png
