danylipsker/HIGH-RATIO-GEAR-SET/output/ratio-500_m1_planet32/layout_sectionA.png

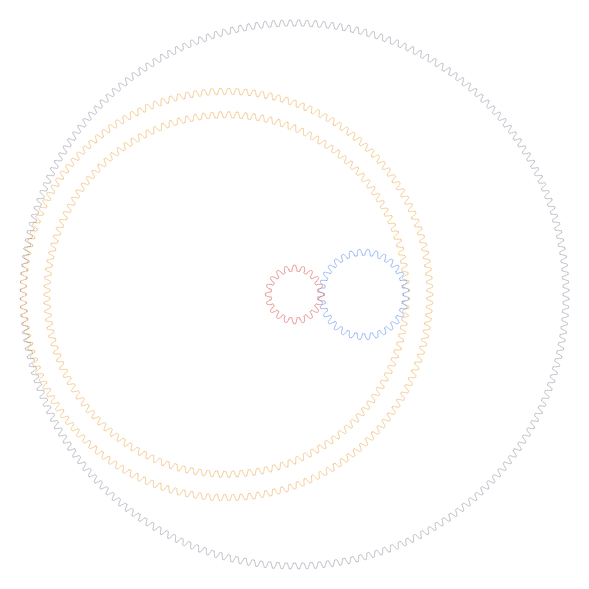
output/ratio-500_m1_planet32/layout_sectionA.png
