danylipsker/HIGH-RATIO-GEAR-SET/output/ratio-500_m1_planet32/layout_sectionB.png

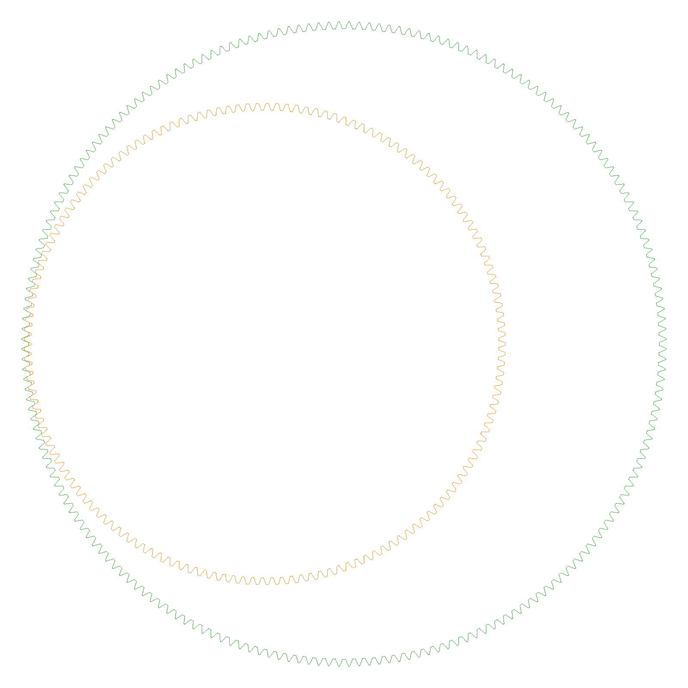
output/ratio-500_m1_planet32/layout_sectionB.png
