danylipsker/HIGH-RATIO-GEAR-SET/output/ratio-500_m1_sun16/layout_sectionA.png

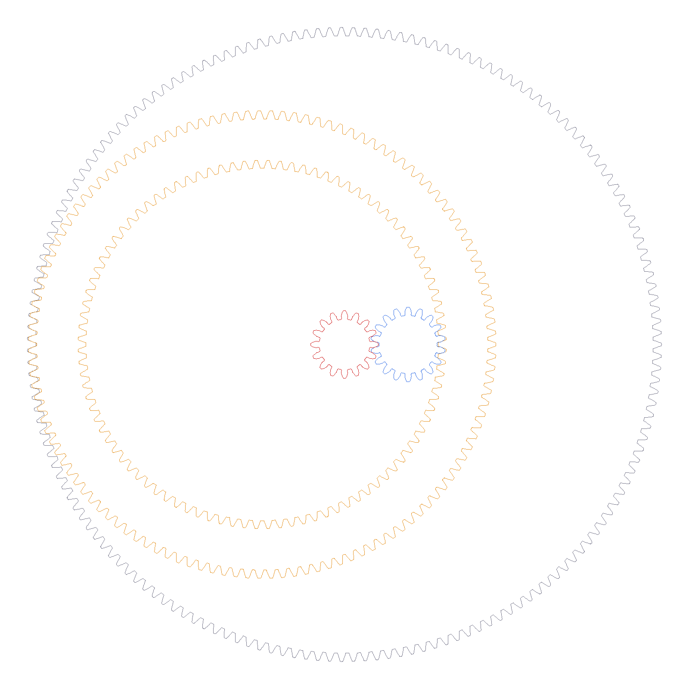
output/ratio-500_m1_sun16/layout_sectionA.png
