danylipsker/HIGH-RATIO-GEAR-SET/output/ratio-528.7_m1.5_thin_ring/layout_sectionA.png

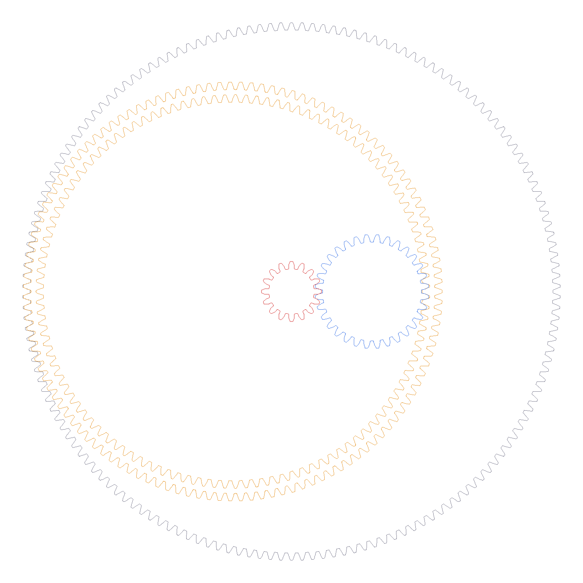
output/ratio-528.7_m1.5_thin_ring/layout_sectionA.png
