danylipsker/HIGH-RATIO-GEAR-SET/output/ratio-500_m1/dxf/layout_sectionA.dxf

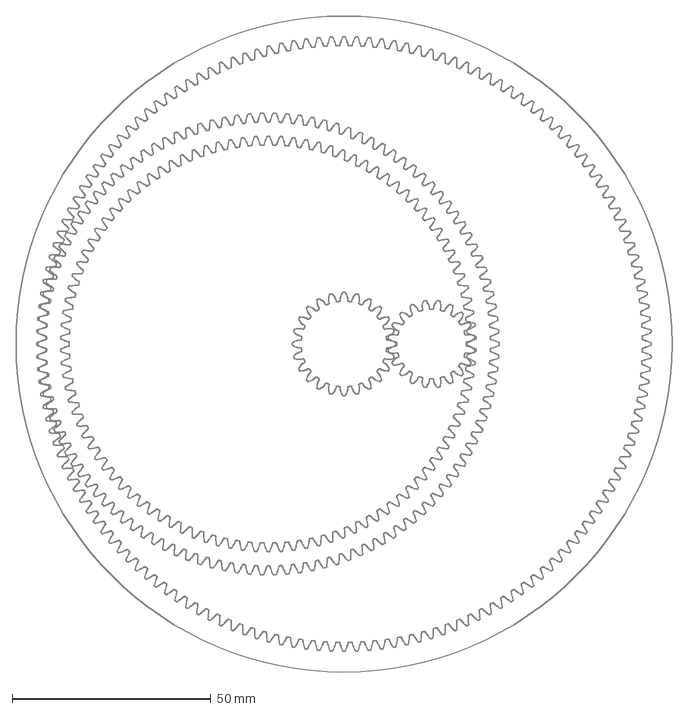
[picture p7: CAD file, 2026-10-27]
output/ratio-500_m1/dxf/layout_sectionA.dxf
164.9 x 164.9 mm
