danylipsker/HIGH-RATIO-GEAR-SET/output/ratio-500_m1/stl/sun.stl

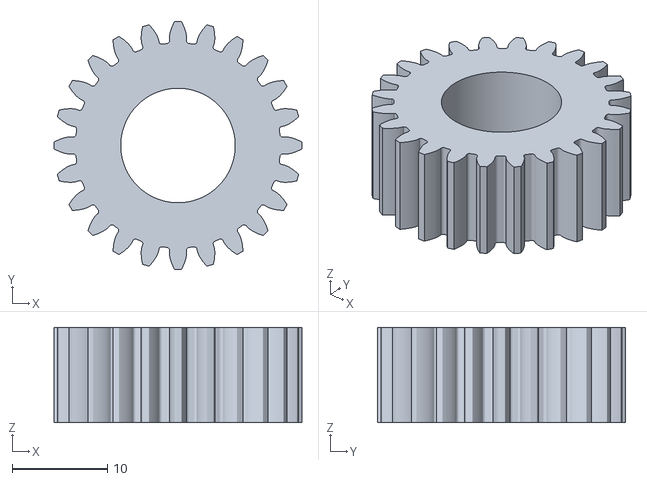
[picture p8: CAD file, 2026-10-27]
output/ratio-500_m1/stl/sun.stl
26.0 x 26.0 x 10.0
