danylipsker/HIGH-RATIO-GEAR-SET/output/ratio-500_m1_planet32/dxf/layout_sectionA.dxf

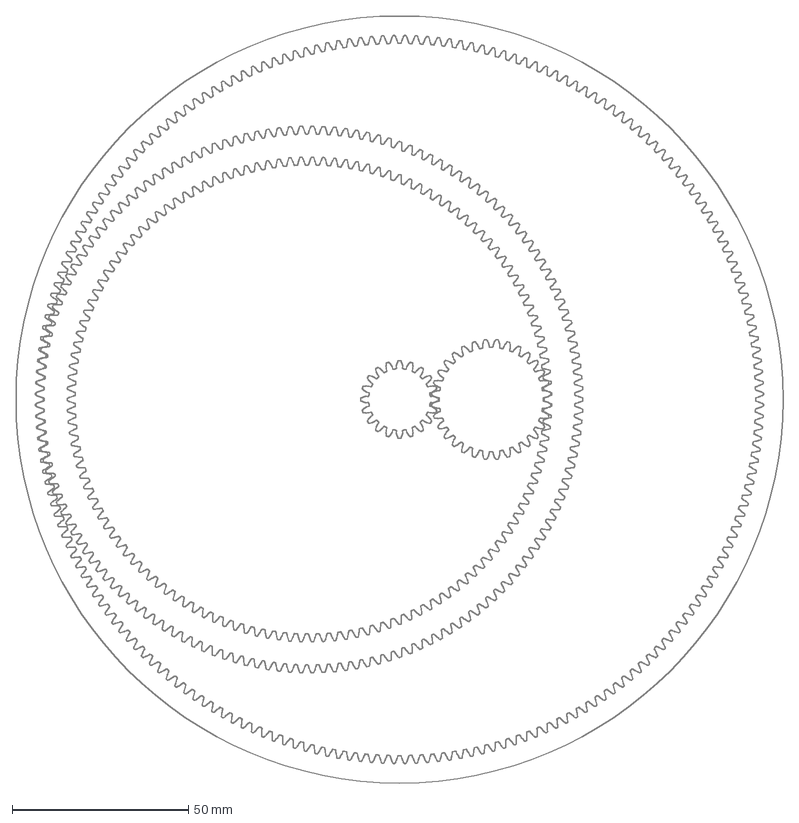
[picture p9: CAD file, 2026-10-27]
output/ratio-500_m1_planet32/dxf/layout_sectionA.dxf
217.5 x 217.5 mm
