danylipsker/HIGH-RATIO-GEAR-SET/output/ratio-500_m1_planet32/stl/planet.stl

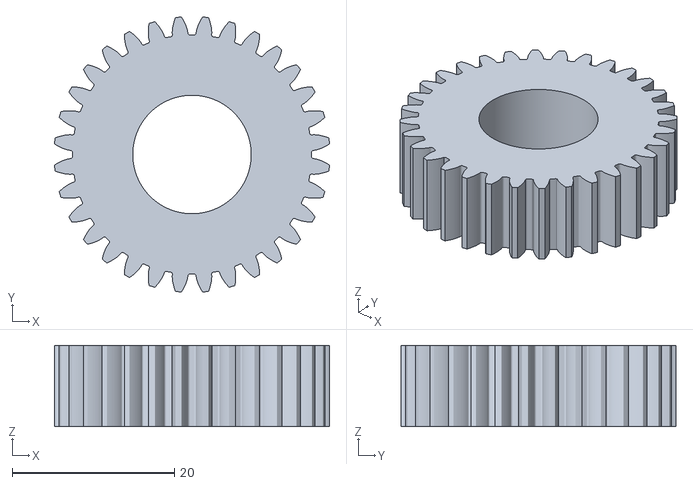
[picture p10: CAD file, 2026-10-27]
output/ratio-500_m1_planet32/stl/planet.stl
33.9 x 33.9 x 10.0
