danylipsker/HIGH-RATIO-GEAR-SET/output/ratio-500_m1_sun16/dxf/layout_sectionA.dxf

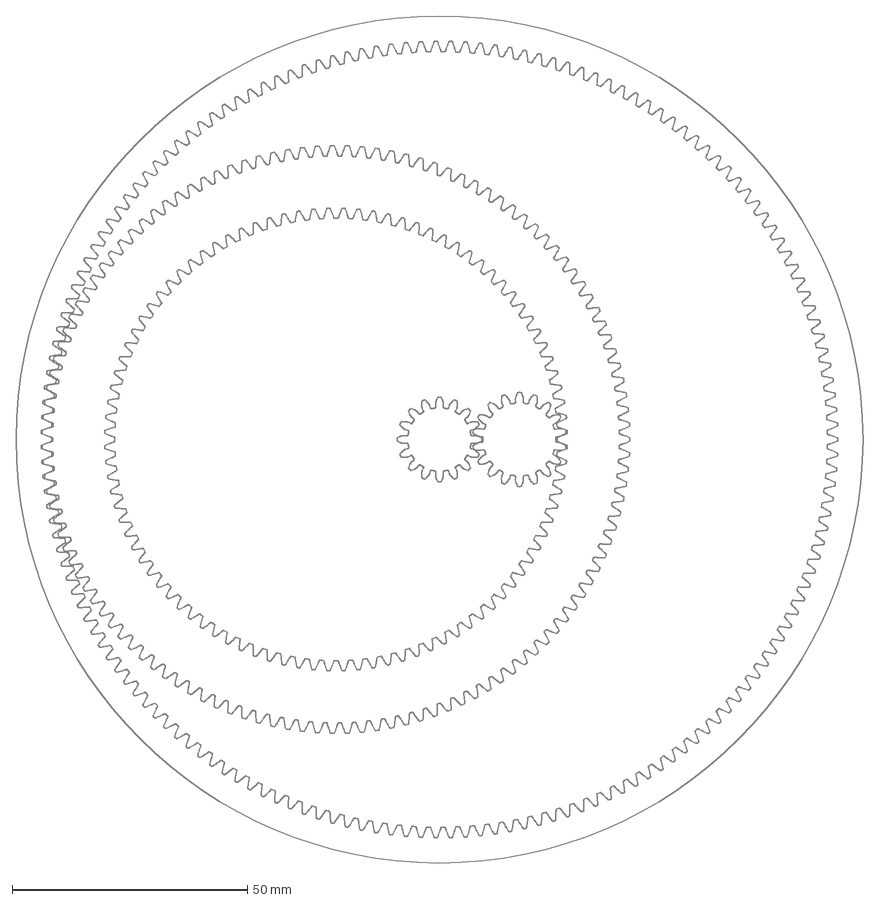
[picture p11: CAD file, 2026-10-27]
output/ratio-500_m1_sun16/dxf/layout_sectionA.dxf
180.2 x 180.2 mm
