danylipsker/HIGH-RATIO-GEAR-SET/output/ratio-500_m1_sun16/stl/thin_ring_sectionA.stl

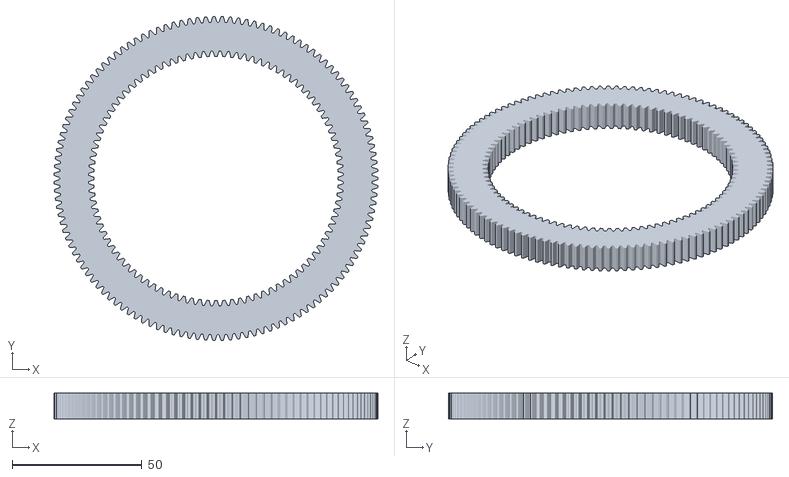
[picture p12: CAD file, 2026-10-27]
output/ratio-500_m1_sun16/stl/thin_ring_sectionA.stl
125.0 x 125.0 x 10.0
