danylipsker/HIGH-RATIO-GEAR-SET/output/ratio-528.7_m1.25_thin_ring/dxf/layout_sectionA.dxf

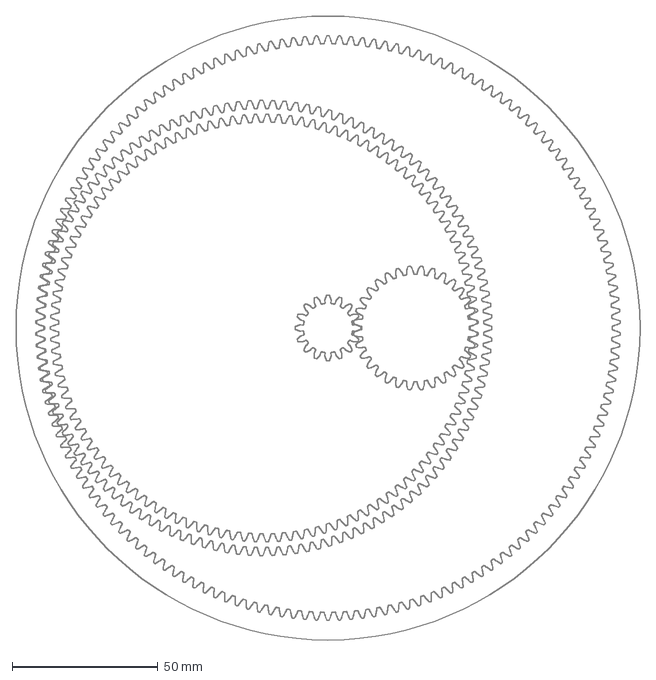
[picture p13: CAD file, 2026-10-27]
output/ratio-528.7_m1.25_thin_ring/dxf/layout_sectionA.dxf
214.2 x 214.2 mm
