danylipsker/HIGH-RATIO-GEAR-SET/output/ratio-528.7_m1.25_thin_ring/stl/sun.stl

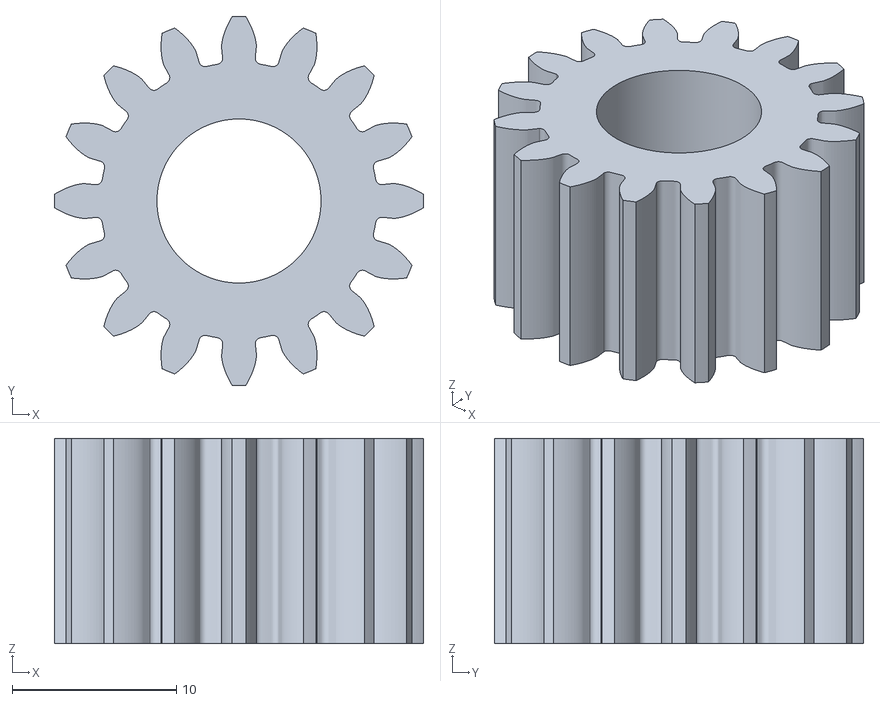
[picture p14: CAD file, 2026-10-27]
output/ratio-528.7_m1.25_thin_ring/stl/sun.stl
22.5 x 22.5 x 12.5
