danylipsker/HIGH-RATIO-GEAR-SET/output/ratio-528.7_m1.5_thin_ring/dxf/layout_sectionA.dxf

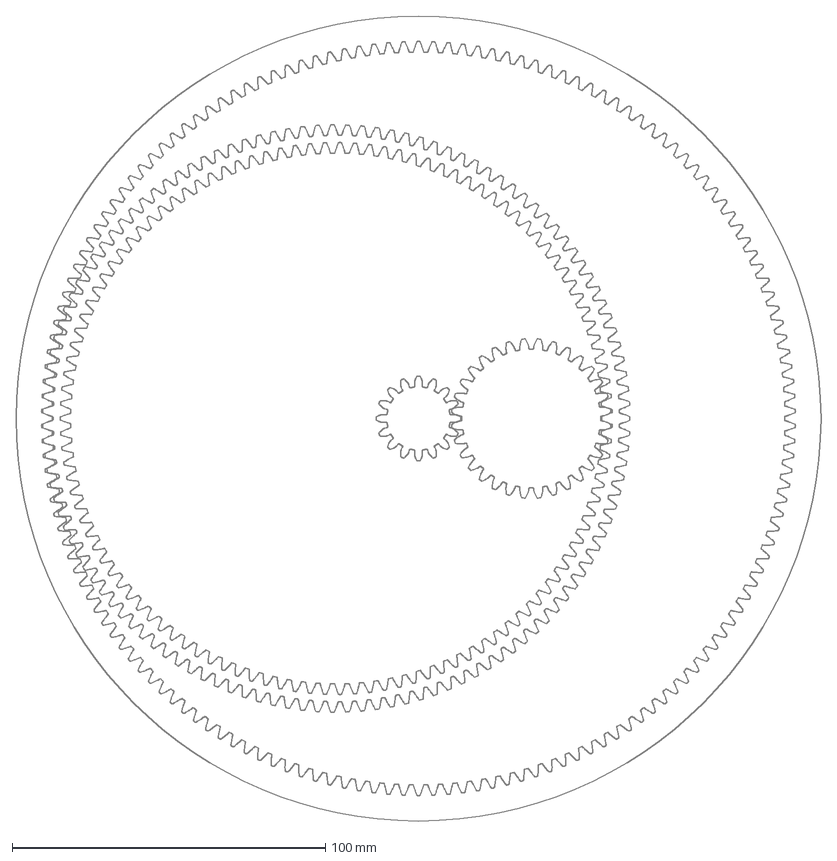
[picture p15: CAD file, 2026-10-27]
output/ratio-528.7_m1.5_thin_ring/dxf/layout_sectionA.dxf
257.0 x 257.0 mm
