danylipsker/HIGH-RATIO-GEAR-SET/output/ratio-528.7_m1.5_thin_ring/stl/sun.stl

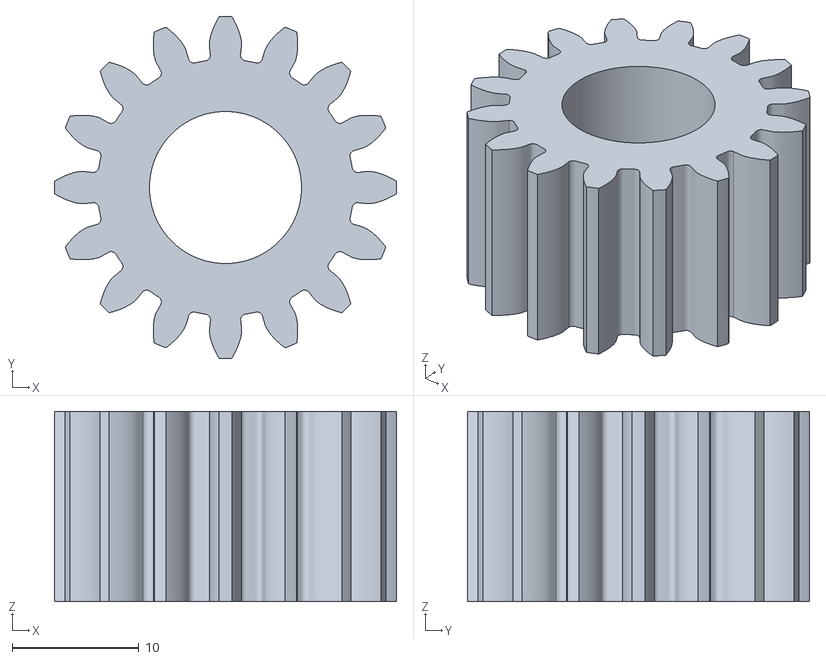
[picture p16: CAD file, 2026-10-27]
output/ratio-528.7_m1.5_thin_ring/stl/sun.stl
27.0 x 27.0 x 15.0
