danylipsker/HIGH-RATIO-GEAR-SET/output/ratio-528.7_m1_thin_ring/dxf/layout_sectionA.dxf

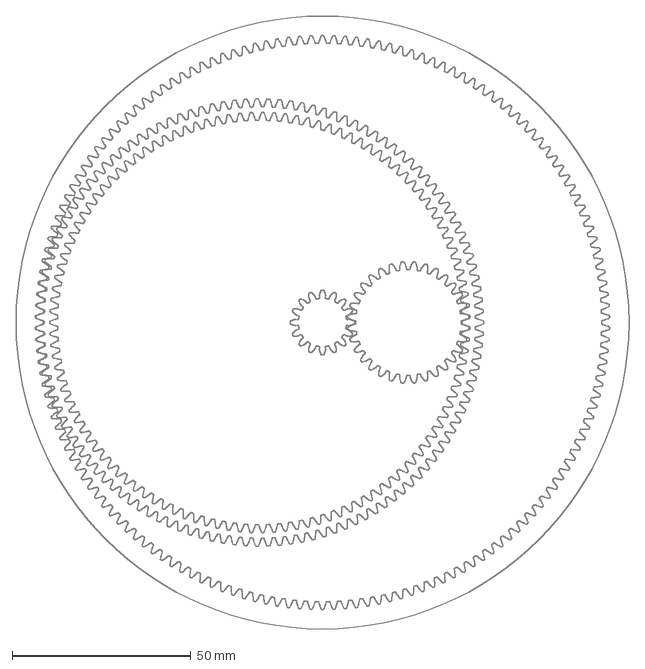
[picture p17: CAD file, 2026-10-27]
output/ratio-528.7_m1_thin_ring/dxf/layout_sectionA.dxf
171.3 x 171.3 mm
