danylipsker/HIGH-RATIO-GEAR-SET/output/ratio-528.7_m1_thin_ring/stl/sun.stl

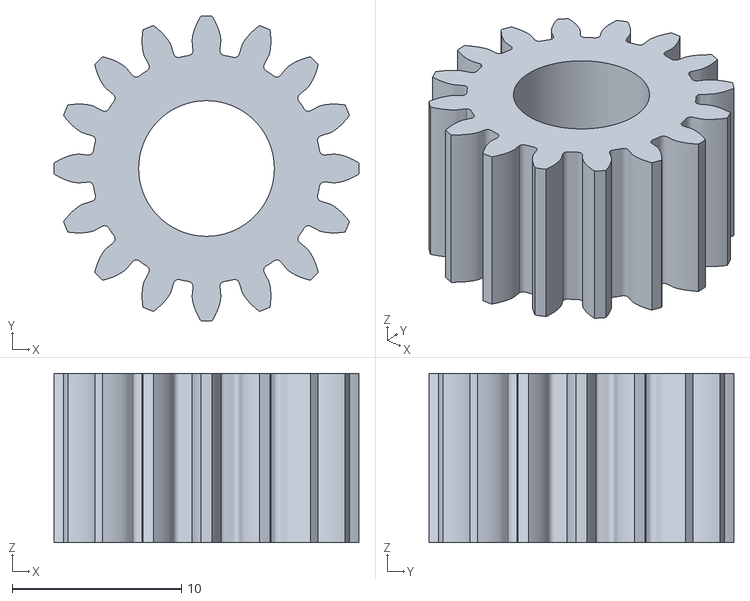
[picture p18: CAD file, 2026-10-27]
output/ratio-528.7_m1_thin_ring/stl/sun.stl
18.0 x 18.0 x 10.0
