danylipsker/HIGH-RATIO-GEAR-SET/output/ratio-528.7_m2_thin_ring/stl/planet.stl

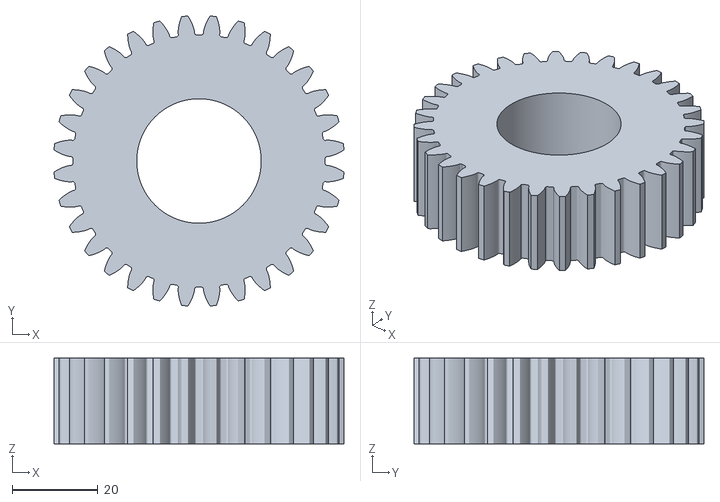
[picture p20: CAD file, 2026-10-27]
output/ratio-528.7_m2_thin_ring/stl/planet.stl
67.8 x 67.8 x 20.0
