danylipsker/HIGH-RATIO-GEAR-SET/output/ratio-500_m1/stl/planet.stl

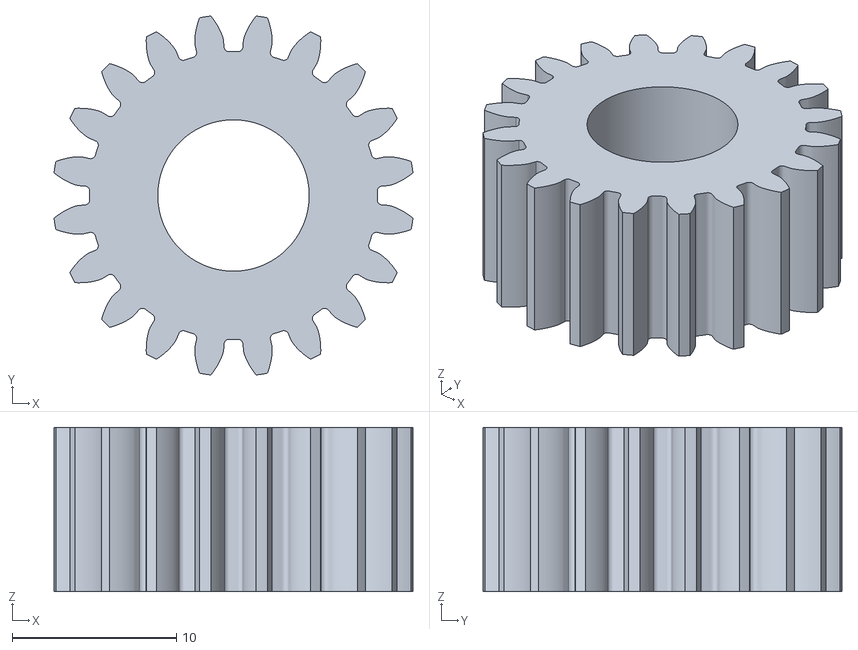
[picture p22: CAD file, 2026-10-27]
output/ratio-500_m1/stl/planet.stl
21.8 x 21.8 x 10.0
