danylipsker/HIGH-RATIO-GEAR-SET/output/ratio-500_m1_planet32/dxf/layout_sectionB.dxf

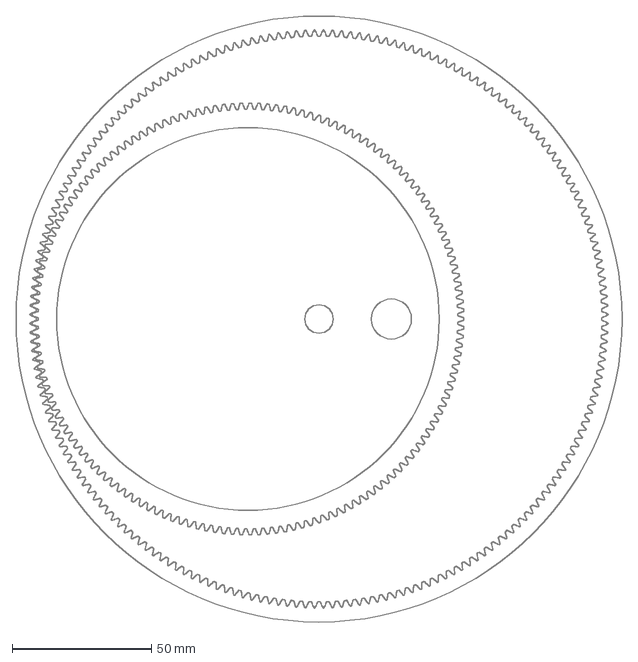
[picture p23: CAD file, 2026-10-27]
output/ratio-500_m1_planet32/dxf/layout_sectionB.dxf
217.5 x 217.5 mm
