danylipsker/HIGH-RATIO-GEAR-SET/output/ratio-500_m1_sun16/dxf/layout_sectionB.dxf

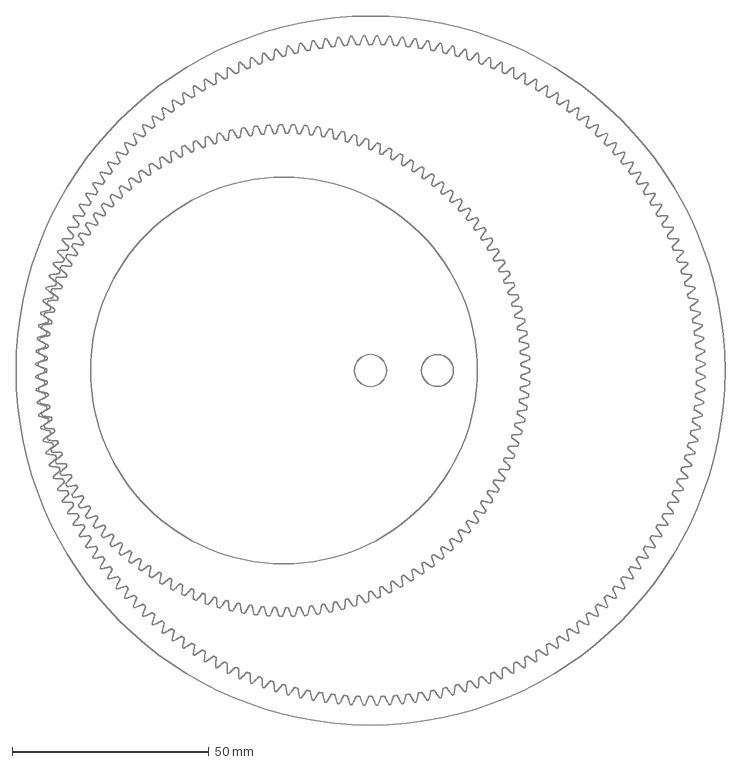
[picture p24: CAD file, 2026-10-27]
output/ratio-500_m1_sun16/dxf/layout_sectionB.dxf
180.2 x 180.2 mm
