danylipsker/HIGH-RATIO-GEAR-SET/output/ratio-528.7_m1.25_thin_ring/dxf/layout_sectionB.dxf

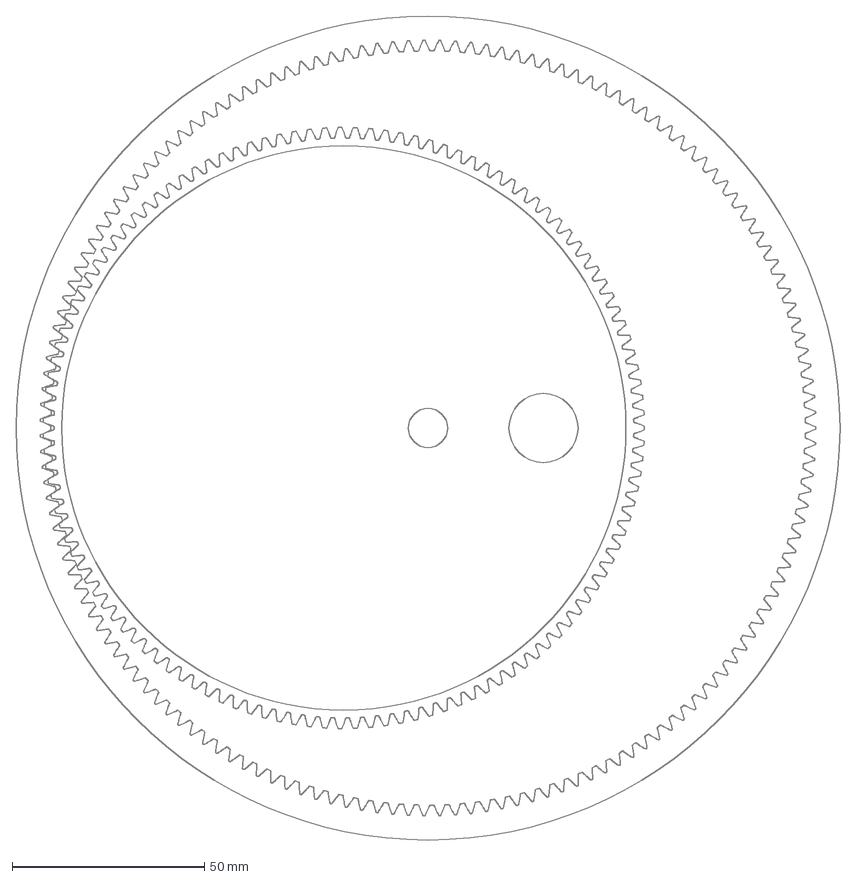
[picture p25: CAD file, 2026-10-27]
output/ratio-528.7_m1.25_thin_ring/dxf/layout_sectionB.dxf
214.2 x 214.2 mm
