danylipsker/HIGH-RATIO-GEAR-SET/output/ratio-528.7_m1.25_thin_ring/stl/planet.stl

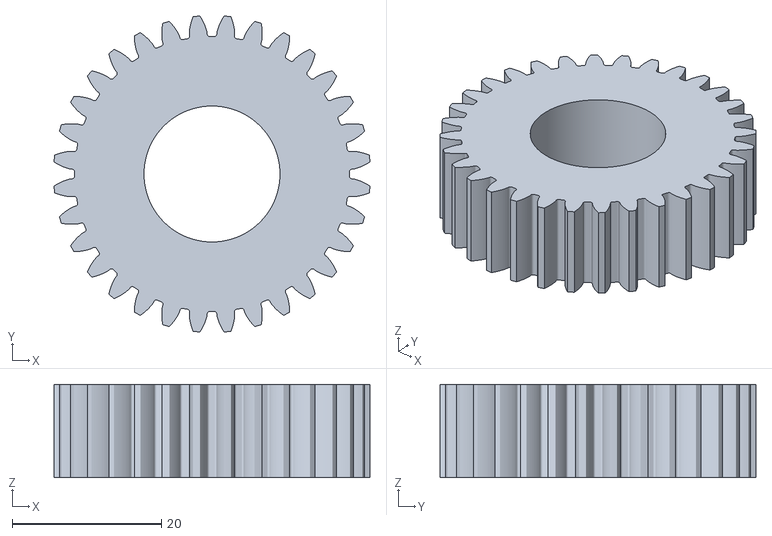
[picture p26: CAD file, 2026-10-27]
output/ratio-528.7_m1.25_thin_ring/stl/planet.stl
42.4 x 42.4 x 12.5
