danylipsker/HIGH-RATIO-GEAR-SET/output/ratio-528.7_m1.5_thin_ring/dxf/layout_sectionB.dxf

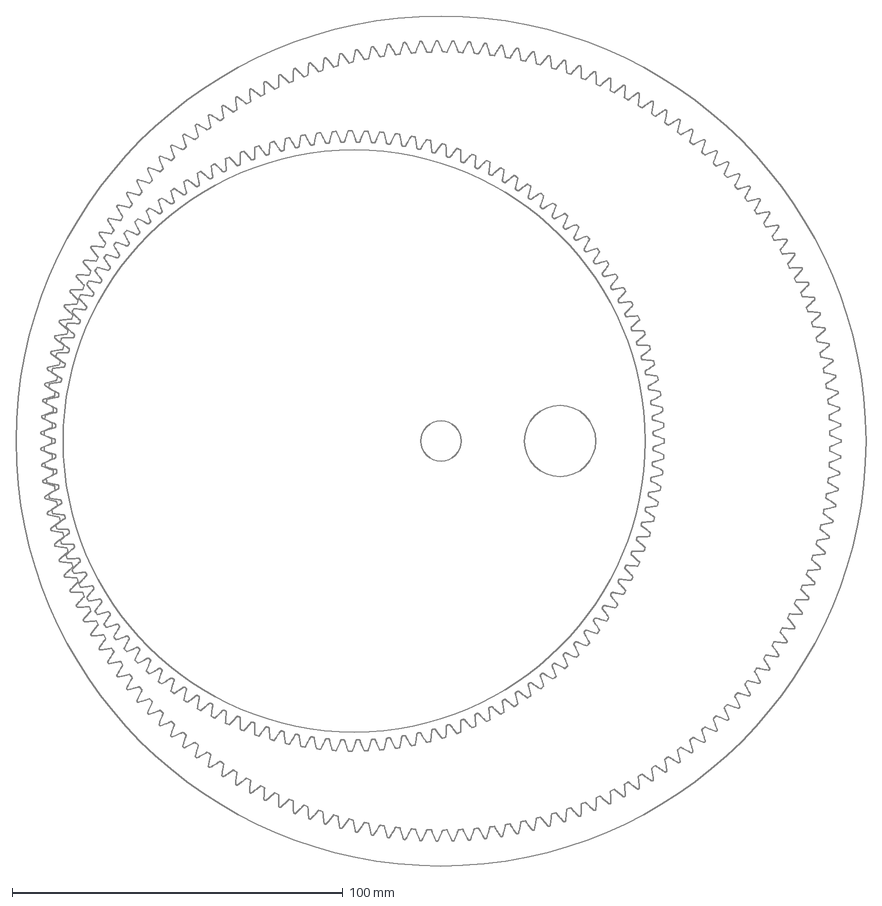
[picture p27: CAD file, 2026-10-27]
output/ratio-528.7_m1.5_thin_ring/dxf/layout_sectionB.dxf
257.0 x 257.0 mm
