danylipsker/HIGH-RATIO-GEAR-SET/output/ratio-528.7_m1.5_thin_ring/stl/planet.stl

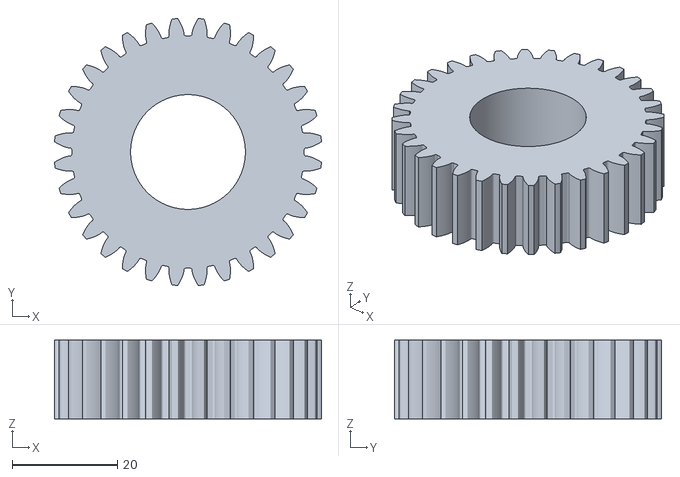
[picture p28: CAD file, 2026-10-27]
output/ratio-528.7_m1.5_thin_ring/stl/planet.stl
50.9 x 50.9 x 15.0
