danylipsker/HIGH-RATIO-GEAR-SET/output/ratio-528.7_m1_thin_ring/dxf/layout_sectionB.dxf

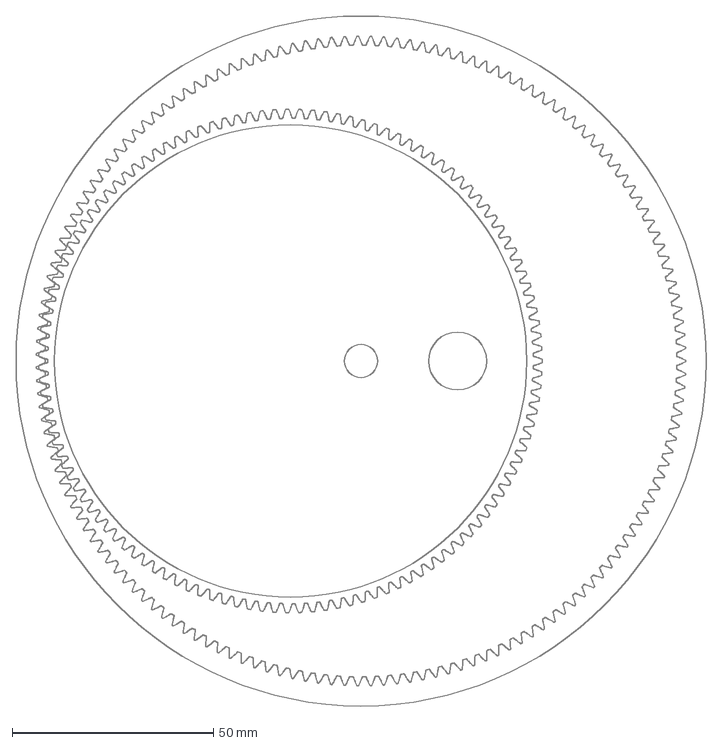
[picture p29: CAD file, 2026-10-27]
output/ratio-528.7_m1_thin_ring/dxf/layout_sectionB.dxf
171.3 x 171.3 mm
