danylipsker/HIGH-RATIO-GEAR-SET/output/ratio-528.7_m2_thin_ring/dxf/layout_sectionB.dxf

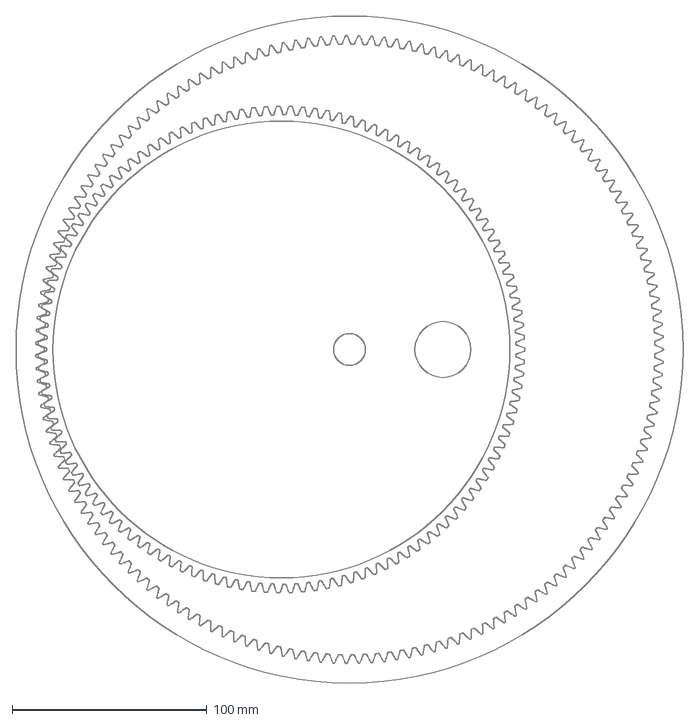
[picture p30: CAD file, 2026-10-27]
output/ratio-528.7_m2_thin_ring/dxf/layout_sectionB.dxf
342.7 x 342.7 mm
