danylipsker/HIGH-RATIO-GEAR-SET/output/ratio-528.7_m2_thin_ring/stl/sun.stl

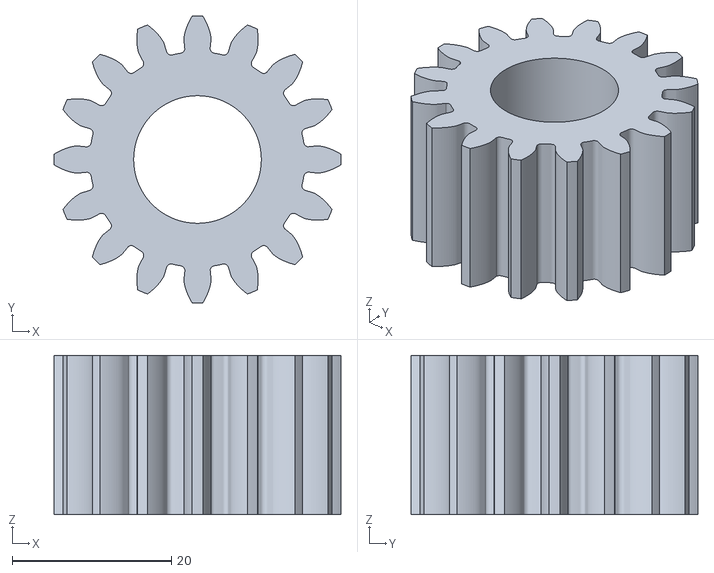
[picture p31: CAD file, 2026-10-27]
output/ratio-528.7_m2_thin_ring/stl/sun.stl
36.0 x 36.0 x 20.0
