danylipsker/HIGH-RATIO-GEAR-SET/output/ratio-500_m1/dxf/carrier.dxf

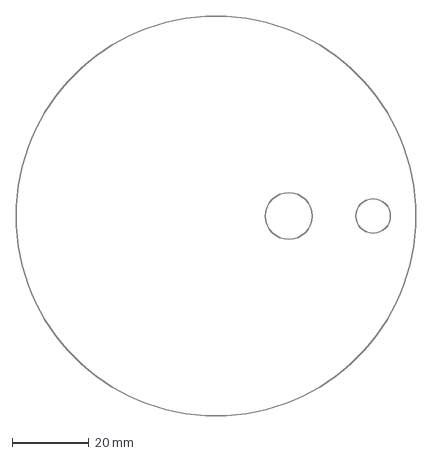
[picture p32: CAD file, 2026-10-25]
output/ratio-500_m1/dxf/carrier.dxf
104.3 x 104.3 mm
