danylipsker/HIGH-RATIO-GEAR-SET/output/ratio-500_m1/stl/thin_ring_sectionA.stl

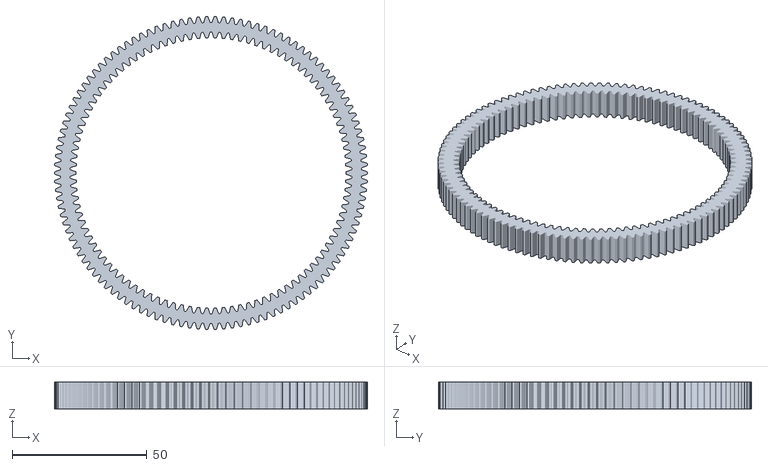
[picture p33: CAD file, 2026-10-25]
output/ratio-500_m1/stl/thin_ring_sectionA.stl
116.0 x 116.0 x 10.0
