danylipsker/HIGH-RATIO-GEAR-SET/output/ratio-500_m1_planet32/dxf/carrier.dxf

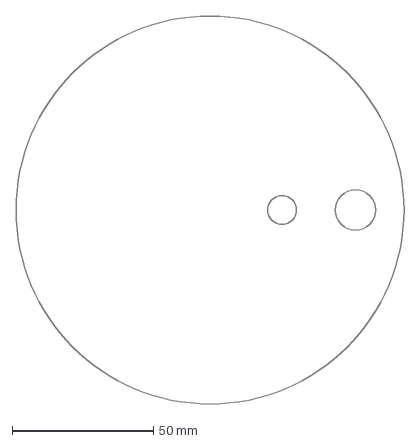
[picture p34: CAD file, 2026-10-25]
output/ratio-500_m1_planet32/dxf/carrier.dxf
137.3 x 137.3 mm
