danylipsker/HIGH-RATIO-GEAR-SET/output/ratio-500_m1_planet32/stl/thin_ring_sectionA.stl

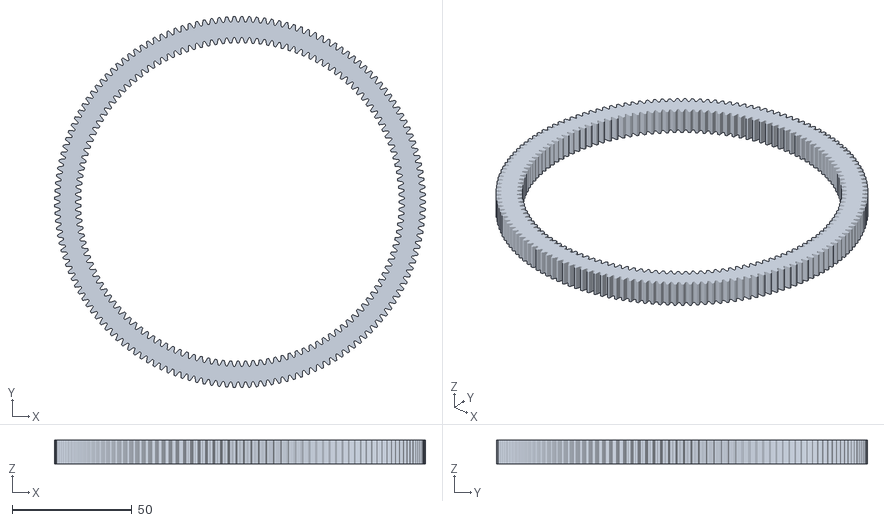
[picture p35: CAD file, 2026-10-25]
output/ratio-500_m1_planet32/stl/thin_ring_sectionA.stl
155.0 x 155.0 x 10.0
