danylipsker/HIGH-RATIO-GEAR-SET/output/ratio-500_m1_sun16/dxf/carrier.dxf

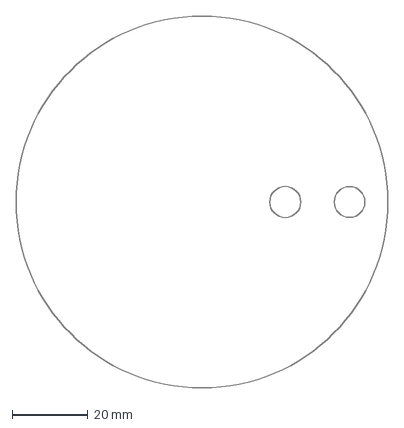
[picture p36: CAD file, 2026-10-25]
output/ratio-500_m1_sun16/dxf/carrier.dxf
98.3 x 98.3 mm
