danylipsker/HIGH-RATIO-GEAR-SET/output/ratio-500_m1_sun16/stl/planet.stl

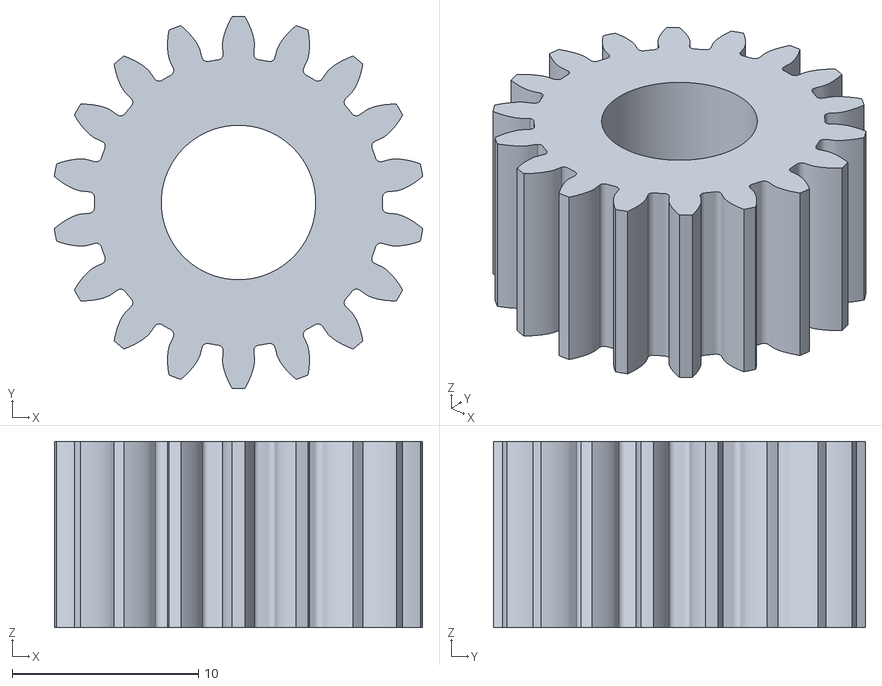
[picture p37: CAD file, 2026-10-27]
output/ratio-500_m1_sun16/stl/planet.stl
19.8 x 20.0 x 10.0
