danylipsker/HIGH-RATIO-GEAR-SET/output/ratio-528.7_m1.25_thin_ring/dxf/carrier.dxf

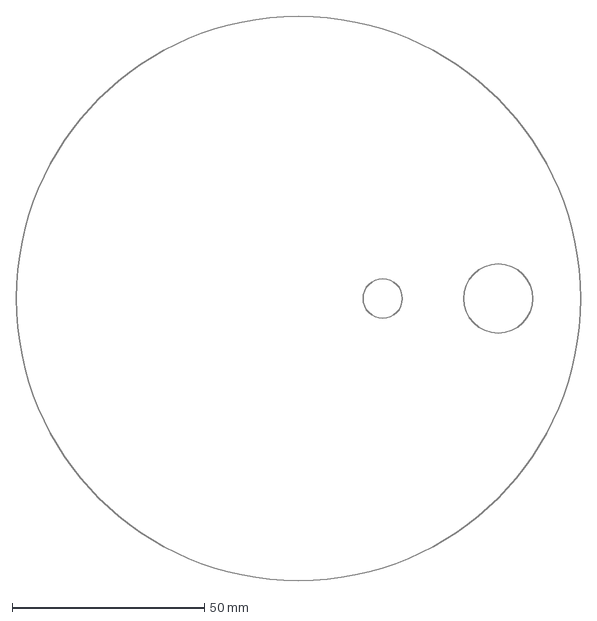
[picture p38: CAD file, 2026-10-25]
output/ratio-528.7_m1.25_thin_ring/dxf/carrier.dxf
146.6 x 146.6 mm
