danylipsker/HIGH-RATIO-GEAR-SET/output/ratio-528.7_m1.5_thin_ring/dxf/carrier.dxf

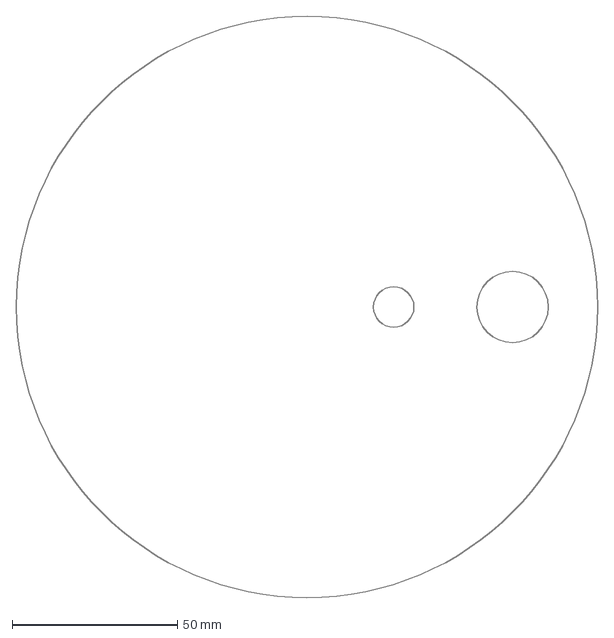
[picture p40: CAD file, 2026-10-25]
output/ratio-528.7_m1.5_thin_ring/dxf/carrier.dxf
176.0 x 176.0 mm
