danylipsker/HIGH-RATIO-GEAR-SET/output/ratio-528.7_m1_thin_ring/dxf/carrier.dxf

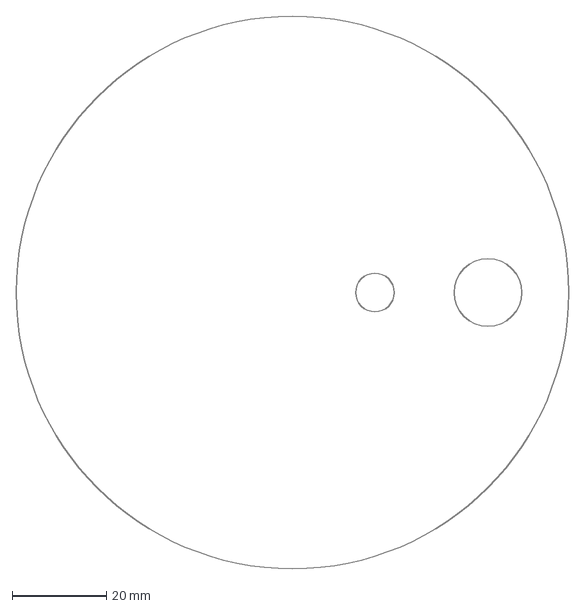
[picture p42: CAD file, 2026-10-25]
output/ratio-528.7_m1_thin_ring/dxf/carrier.dxf
117.3 x 117.3 mm
