danylipsker/HIGH-RATIO-GEAR-SET/output/ratio-528.7_m2_thin_ring/dxf/carrier.dxf

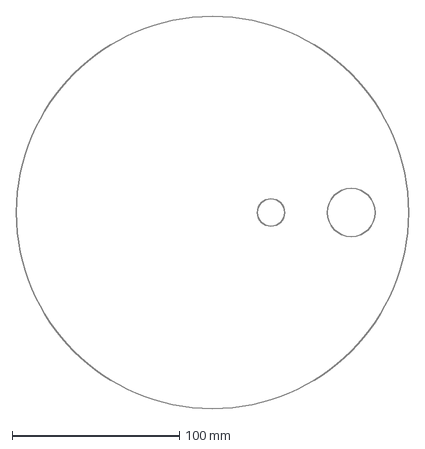
[picture p44: CAD file, 2026-10-25]
output/ratio-528.7_m2_thin_ring/dxf/carrier.dxf
234.7 x 234.7 mm
