danylipsker/HIGH-RATIO-GEAR-SET/output/ratio-500_m1/stl/output_ring.stl

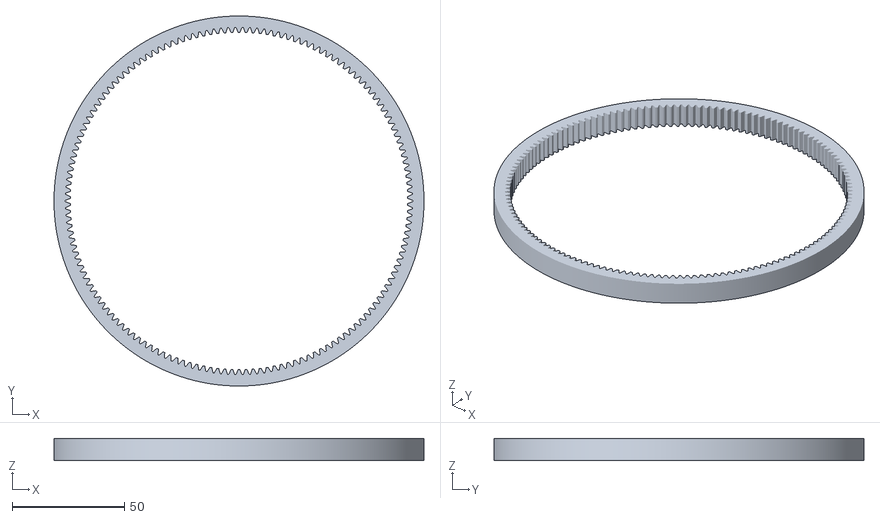
[picture p46: CAD file, 2026-10-25]
output/ratio-500_m1/stl/output_ring.stl
164.9 x 164.9 x 10.0
