danylipsker/HIGH-RATIO-GEAR-SET/output/ratio-500_m1_planet32/stl/output_ring.stl

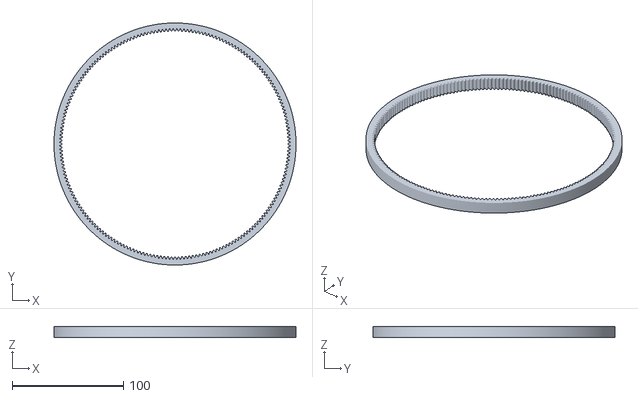
[picture p47: CAD file, 2026-10-25]
output/ratio-500_m1_planet32/stl/output_ring.stl
217.5 x 217.5 x 10.0
