danylipsker/HIGH-RATIO-GEAR-SET/output/ratio-500_m1_sun16/stl/output_ring.stl

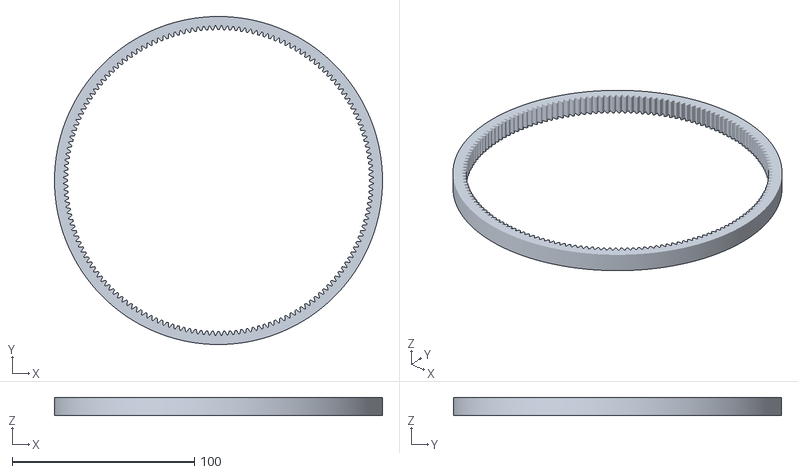
[picture p48: CAD file, 2026-10-25]
output/ratio-500_m1_sun16/stl/output_ring.stl
180.2 x 180.2 x 10.0
