danylipsker/HIGH-RATIO-GEAR-SET/output/ratio-528.7_m1.25_thin_ring/stl/thin_ring_sectionA.stl

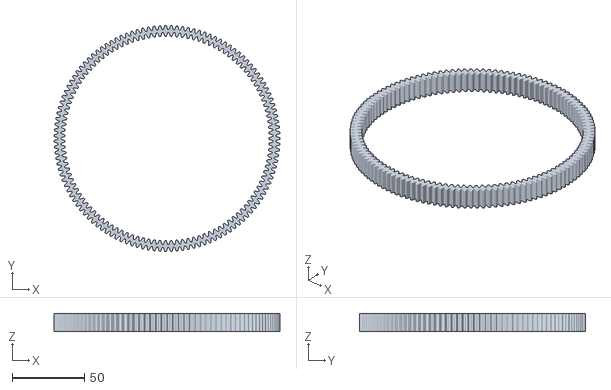
[picture p49: CAD file, 2026-10-25]
output/ratio-528.7_m1.25_thin_ring/stl/thin_ring_sectionA.stl
156.2 x 156.2 x 12.5
