danylipsker/HIGH-RATIO-GEAR-SET/output/ratio-528.7_m1.5_thin_ring/stl/thin_ring_sectionB.stl

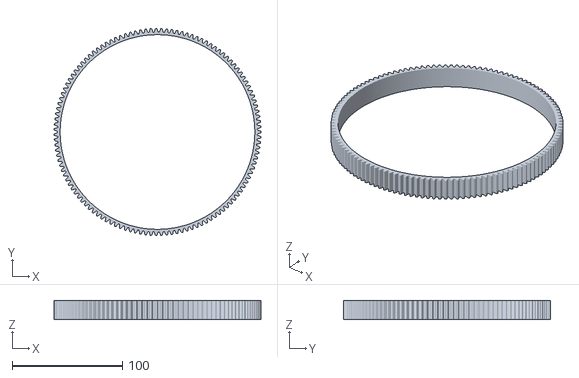
[picture p50: CAD file, 2026-10-25]
output/ratio-528.7_m1.5_thin_ring/stl/thin_ring_sectionB.stl
187.5 x 187.5 x 17.2
