danylipsker/HIGH-RATIO-GEAR-SET/output/ratio-528.7_m2_thin_ring/stl/output_ring.stl

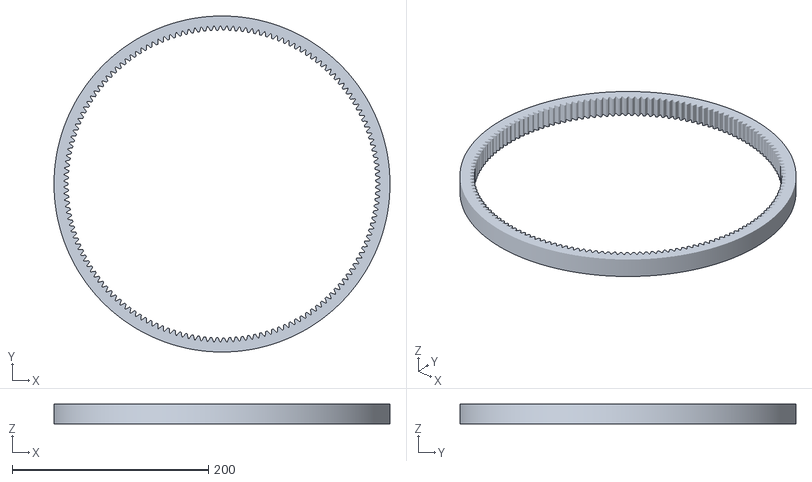
[picture p52: CAD file, 2026-10-25]
output/ratio-528.7_m2_thin_ring/stl/output_ring.stl
342.7 x 342.7 x 20.0
