danylipsker/HIGH-RATIO-GEAR-SET/output/ratio-500_m1_sun16/stl/thin_ring_sectionB.stl

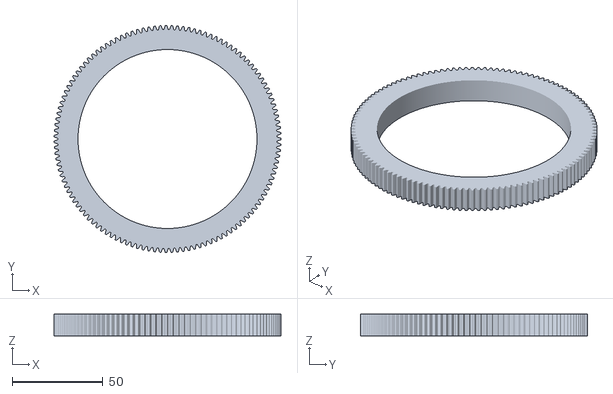
[picture p54: CAD file, 2026-10-25]
output/ratio-500_m1_sun16/stl/thin_ring_sectionB.stl
125.0 x 125.0 x 12.0
