danylipsker/HIGH-RATIO-GEAR-SET/output/ratio-528.7_m1.5_thin_ring/stl/thin_ring_sectionA.stl

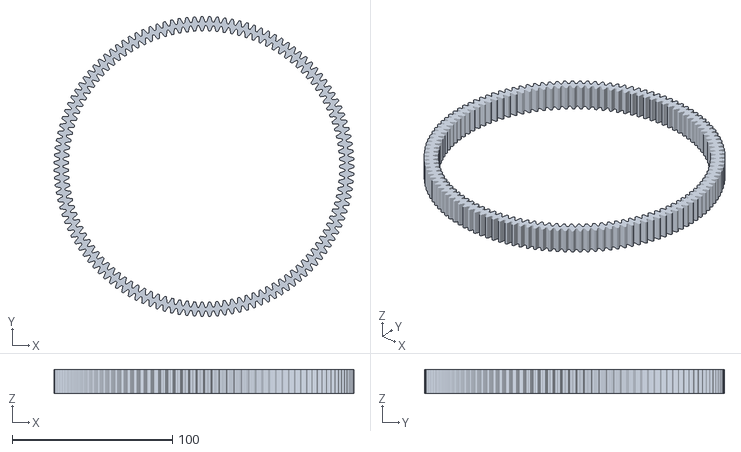
[picture p56: CAD file, 2026-10-25]
output/ratio-528.7_m1.5_thin_ring/stl/thin_ring_sectionA.stl
187.5 x 187.5 x 15.0
