danylipsker/HIGH-RATIO-GEAR-SET/output/ratio-528.7_m1_thin_ring/stl/fixed_ring.stl

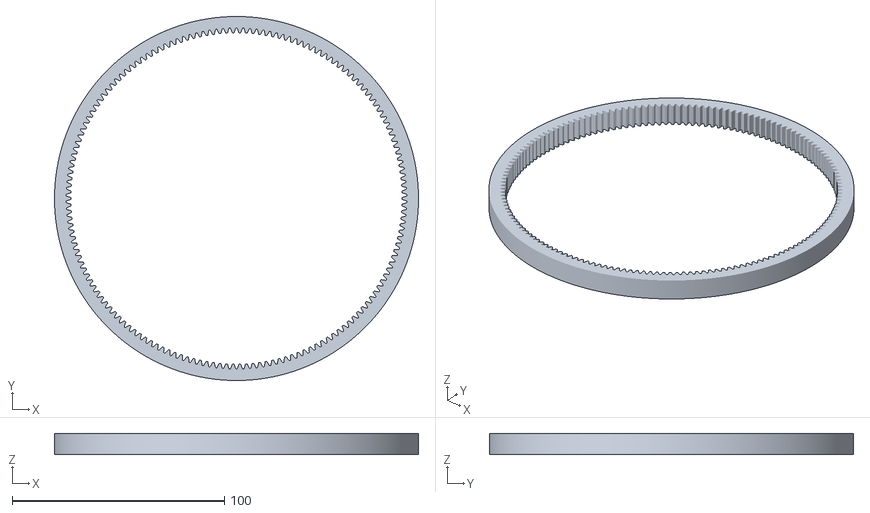
[picture p57: CAD file, 2026-10-25]
output/ratio-528.7_m1_thin_ring/stl/fixed_ring.stl
171.3 x 171.3 x 10.0
