danylipsker/HIGH-RATIO-GEAR-SET/output/ratio-528.7_m2_thin_ring/stl/fixed_ring.stl

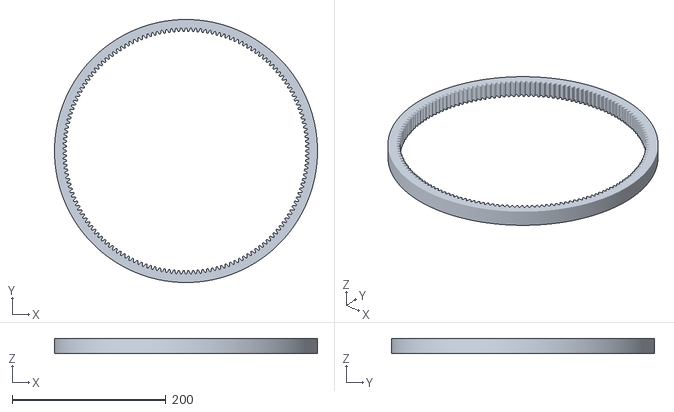
[picture p58: CAD file, 2026-10-25]
output/ratio-528.7_m2_thin_ring/stl/fixed_ring.stl
342.7 x 342.7 x 20.0
