danylipsker/HIGH-RATIO-GEAR-SET/output/ratio-500_m1_planet32/stl/fixed_ring.stl

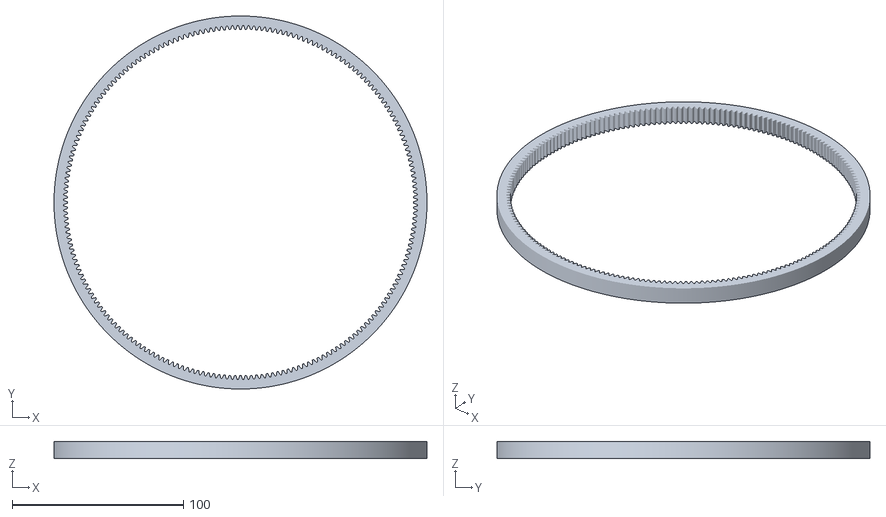
[picture p59: CAD file, 2026-10-25]
output/ratio-500_m1_planet32/stl/fixed_ring.stl
217.5 x 217.5 x 10.0
