danylipsker/HIGH-RATIO-GEAR-SET/output/ratio-528.7_m1.25_thin_ring/stl/fixed_ring.stl

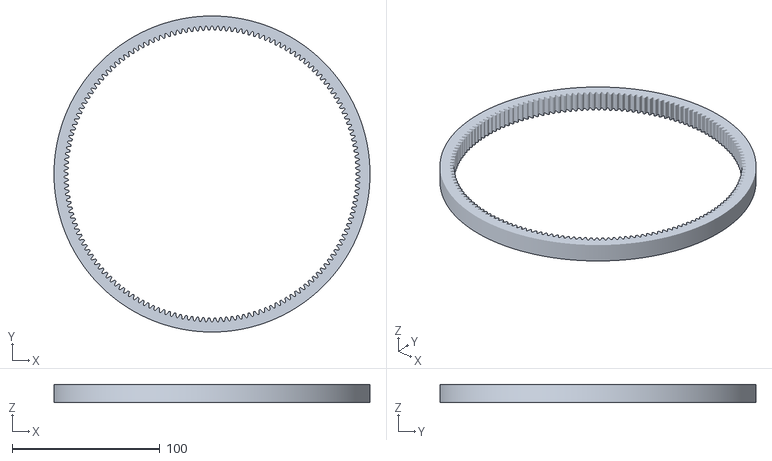
[picture p60: CAD file, 2026-10-25]
output/ratio-528.7_m1.25_thin_ring/stl/fixed_ring.stl
214.2 x 214.2 x 12.5
