danylipsker/HIGH-RATIO-GEAR-SET/output/ratio-528.7_m1.5_thin_ring/stl/output_ring.stl

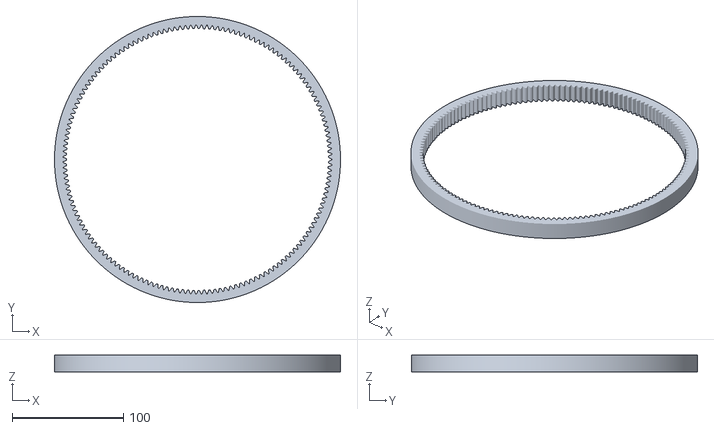
[picture p61: CAD file, 2026-10-25]
output/ratio-528.7_m1.5_thin_ring/stl/output_ring.stl
257.0 x 257.0 x 15.0
