danylipsker/HIGH-RATIO-GEAR-SET/output/ratio-528.7_m1_thin_ring/stl/thin_ring_sectionA.stl

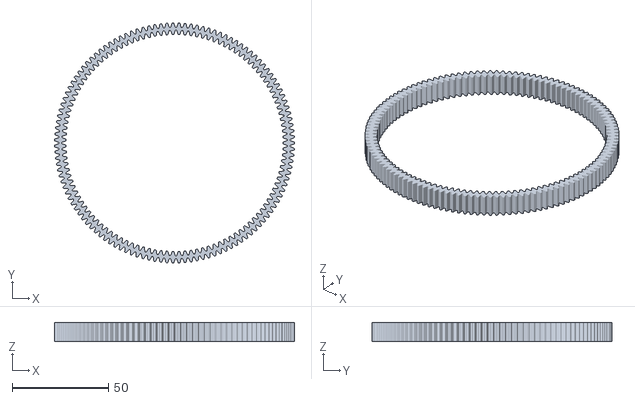
[picture p62: CAD file, 2026-10-25]
output/ratio-528.7_m1_thin_ring/stl/thin_ring_sectionA.stl
125.0 x 125.0 x 10.0
