danylipsker/HIGH-RATIO-GEAR-SET/output/ratio-528.7_m2_thin_ring/stl/thin_ring_sectionA.stl

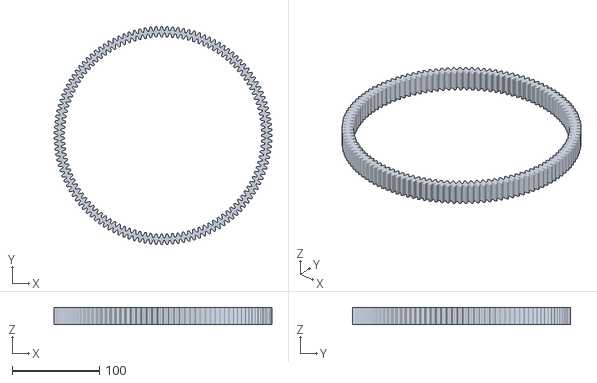
[picture p63: CAD file, 2026-10-25]
output/ratio-528.7_m2_thin_ring/stl/thin_ring_sectionA.stl
250.0 x 250.0 x 20.0
