danylipsker/HIGH-RATIO-GEAR-SET/(list of files, cad)

Other CAD files:
output/ratio-500_m1_planet32/stl/sun.stl
output/ratio-500_m1/stl/fixed_ring.stl
output/ratio-500_m1/stl/thin_ring_sectionB.stl
output/ratio-500_m1_sun16/stl/fixed_ring.stl
output/ratio-500_m1/dxf/fixed_ring.dxf
output/ratio-500_m1/dxf/output_ring.dxf
output/ratio-500_m1/dxf/planet.dxf
output/ratio-500_m1/dxf/sun.dxf
output/ratio-500_m1/dxf/thin_ring_sectionA.dxf
output/ratio-500_m1/dxf/thin_ring_sectionB.dxf
output/ratio-500_m1_planet32/dxf/fixed_ring.dxf
output/ratio-500_m1_planet32/dxf/output_ring.dxf
output/ratio-500_m1_planet32/dxf/planet.dxf
output/ratio-500_m1_planet32/dxf/sun.dxf
output/ratio-500_m1_planet32/dxf/thin_ring_sectionA.dxf
output/ratio-500_m1_planet32/dxf/thin_ring_sectionB.dxf
output/ratio-500_m1_sun16/dxf/fixed_ring.dxf
output/ratio-500_m1_sun16/dxf/output_ring.dxf
output/ratio-500_m1_sun16/dxf/planet.dxf
output/ratio-500_m1_sun16/dxf/sun.dxf
output/ratio-500_m1_sun16/dxf/thin_ring_sectionA.dxf
output/ratio-500_m1_sun16/dxf/thin_ring_sectionB.dxf
output/ratio-528.7_m1.25_thin_ring/dxf/fixed_ring.dxf
output/ratio-528.7_m1.25_thin_ring/dxf/output_ring.dxf
output/ratio-528.7_m1.25_thin_ring/dxf/planet.dxf
output/ratio-528.7_m1.25_thin_ring/dxf/sun.dxf
output/ratio-528.7_m1.25_thin_ring/dxf/thin_ring_sectionA.dxf
output/ratio-528.7_m1.25_thin_ring/dxf/thin_ring_sectionB.dxf
output/ratio-528.7_m1.5_thin_ring/dxf/fixed_ring.dxf
output/ratio-528.7_m1.5_thin_ring/dxf/output_ring.dxf
output/ratio-528.7_m1.5_thin_ring/dxf/planet.dxf
output/ratio-528.7_m1.5_thin_ring/dxf/sun.dxf
output/ratio-528.7_m1.5_thin_ring/dxf/thin_ring_sectionA.dxf
output/ratio-528.7_m1.5_thin_ring/dxf/thin_ring_sectionB.dxf
output/ratio-528.7_m1_thin_ring/dxf/fixed_ring.dxf
output/ratio-528.7_m1_thin_ring/dxf/output_ring.dxf
output/ratio-528.7_m1_thin_ring/dxf/planet.dxf
output/ratio-528.7_m1_thin_ring/dxf/sun.dxf
output/ratio-528.7_m1_thin_ring/dxf/thin_ring_sectionA.dxf
output/ratio-528.7_m1_thin_ring/dxf/thin_ring_sectionB.dxf
output/ratio-528.7_m2_thin_ring/dxf/fixed_ring.dxf
output/ratio-528.7_m2_thin_ring/dxf/output_ring.dxf
output/ratio-528.7_m2_thin_ring/dxf/planet.dxf
output/ratio-528.7_m2_thin_ring/dxf/sun.dxf
output/ratio-528.7_m2_thin_ring/dxf/thin_ring_sectionA.dxf
output/ratio-528.7_m2_thin_ring/dxf/thin_ring_sectionB.dxf
