danylipsker/HIGH-RATIO-GEAR-SET/(commit log)

2026-10-25 feat: parametric high-ratio single-planet 3K gear set generator + SolidWorks macro
    Moved out of danylipsker/fasteners-catalog (PRs #6, #7 there). gearset.py solves exact
    integer tooth sets for a requested ratio / module / size, generates involute outlines,
    DXF / STL / SVG, design reports with kinematic and rolling interference checks, and
    fills the VBA macro that builds the parts and assembly in SolidWorks. Seven generated
    sets under output/, CLAUDE.md hand-off for the local SolidWorks 2020 session.
    Claude-Session: https://claude.ai/code/session_01NwriLP1setSgs97EVKGE2o
    [carrier.dxf, fixed_ring.dxf, fixed_ring.stl, layout_sectionA.dxf, layout_sectionB.dxf, output_ring.dxf, output_ring.stl, planet.dxf]
2026-10-25 feat: SOLIDWORKS add-in - module and ratio in, pick a tooth set, see dimensions, build parts + assembly
    C# add-in (SOLIDWORKS 2020+, same construction as the Fastener Catalog add-in): Gear Set tab
    with a dialog for module, gear ratio, optional tooth counts / size limit / face width / backlash,
    a list of all exact tooth-set solutions (or nearest ratios), overall dimensions of the picked
    set, and a Build button that writes only the six .SLDPRT files and GearSet.SLDASM.
    GearMath.cs is a port of gearset.py (solver, involutes with profile shift, phasing, checks);
    GearBuilder.cs ports the VBA macro to the typed API; GearSetCli.exe shares the code for
    solve / test-dialog / build from the command li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
2026-10-25 test: Mono stub compile check for the add-in; label and docs
    solidworks/stubs: interop stubs + compile_check.sh compile GearSetAddin.dll and GearSetCli.exe
    without SOLIDWORKS (0 errors); the compiled solver matches gearset.py for 1:500, 1:437 and the
    16/32 thin-ring set, and the dialog runs under Xvfb. Shorter pressure-angle label so the options
    row does not wrap; README notes that the tab needs an open document.
    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
2026-10-25 fix(install): 64-bit PowerShell, per-user Addins key, registration check
    The HKLM Addins key was missing after a run that reported success. install.ps1 now re-launches
    itself in 64-bit PowerShell (32-bit writes land in WOW6432Node, unseen by SOLIDWORKS), also writes
    HKCU\Software\SolidWorks\Addins\{guid} without elevation, and ends with a check of the COM class
    and all add-in keys, failing loudly when SOLIDWORKS could not list the add-in.
    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
2026-10-25 feat: the add-in mates the assembly so it animates with one degree of freedom
    Front-Plane coincident mates for the axial positions, concentric mates on the sun shaft, carrier
    pin, carrier journal and ring cylinders, and gear mates from the sun to carrier, planet, thin ring
    and output ring with their exact absolute speed ratios (SOLIDWORKS gear mates act in the assembly
    frame, so tooth counts between meshing pairs would be wrong for a planetary train). Faces are
    found by radius and z range on the component bodies and selected the way the fastener add-in does.
    Dialog checkbox 'add mates' (default on), CLI -no-mates, mate report in the result message and log.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
2026-10-25 docs: gear-mate direction and 1:500 in motion confirmed on SolidWorks 2020
    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
2026-10-25 feat: root fillets on all teeth (0.30 x module default) in the generator and the add-in
    True fillet arcs tangent to the root circle and the flank, shrunk automatically where a tooth space
    is too narrow; dialog box and --fillet / -fillet options. C# outlines verified equal to the Python
    reference to 1e-13 mm (new CLI -dump). Rolling check clean on every committed set at 0.30 x module
    (0.38 would graze the ring tips without tip relief). All output/ sets regenerated.
    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
    [fixed_ring.dxf, fixed_ring.stl, layout_sectionA.dxf, layout_sectionB.dxf, output_ring.dxf, output_ring.stl, planet.dxf, planet.stl]
2026-10-25 feat(dialog): optional fixed output base (used by GEARS GENERATOR's library folder)
    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
2026-10-25 feat: housing with bearings - front cover, shell with clamping lip, output cup with hub, rear cover, 60xx bearings
    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
2026-10-25 feat(add-in): MateImportedAssembly - mates for a STEP-imported assembly of the set
    Used by GEARS GENERATOR's family path: the six gears are recognised by their
    bounding boxes against the layout, the moving five unfixed, then the same mates
    as Build adds. Stubs extended (GetComponents, UnfixComponent, GetBox, IsFixed);
    compile_check.sh passes.
    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
2026-10-25 feat(add-in): Motion Study "Sun drive" with a rotary motor on the sun, after the mates
    Late-bound swmotionstudy calls (dynamic): CreateMotionStudy, Activate,
    SetDuration, CreateMotor(rotary, constant speed, 60 rpm) on the sun's input
    stub, 10 s = 10 sun turns. Stubs: GetMotionStudyManager; compile_check adds
    Microsoft.CSharp. The message boxes report the study.
    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
2026-10-25 feat(dialog): module, ratio, Find solutions, the table, then what follows; Advanced folded
    The dialog in the user's order: 1 module, 2 gear ratio, 3 Find solutions on
    one line, 4 the table (Sense and Overall columns added), 5 the picked row's
    dimensions, folder and Build. Search range, design rules, face width,
    backlash, fillet, an exact set and the presets fold under Advanced. Nearest
    rows are offered only within 15 %; otherwise the status says what the
    mechanism reaches (about 1:216 at the smallest with a 30-tooth sun).
    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
2026-10-25 feat(dialog): the table on top, a blank start, and a staged search that fills it for any ratio
    The dialog opens with the empty table of solutions first, then module, gear
    ratio and Find solutions (blank, nothing remembered or searched until asked),
    then the picked solution. The search runs off the UI thread in stages: exact in
    the range as typed, else exact in a widened range (sun to 60, planet from 10,
    rings up to 6 apart), else the nearest ratios in the widened range, closest
    first - so 1:75 fills the table with the sets around 1:165, the mechanism's
    floor, and the status says so.
    Claude-Session: https://claude.ai/code/session_01Nwr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
2026-10-27 fix: trailing root fillets drawn the short way round (C# builder and DXF writer)
    The mirrored fillet segment is reflected and listed backwards, so its turning
    sense is the original one; the flipped flag made CreateArc and the DXF ARC take
    the long way, a 270 degree loop on every trailing fillet. Fixed in GearMath.cs
    and gearset.py; measured: all fillet arcs of the default set now sweep 66..88
    degrees. The regenerated output sets follow in the next commit.
    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
2026-10-27 fix: regenerate the seven output sets with the trailing fillet arcs the short way round
    Only the DXF files change: the start and end angles of every trailing fillet
    ARC swap, so the arcs sweep 66..88 degrees instead of their complement.
    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
    [fixed_ring.dxf, layout_sectionA.dxf, layout_sectionB.dxf, output_ring.dxf, planet.dxf, sun.dxf, thin_ring_sectionA.dxf, thin_ring_sectionB.dxf]
2026-10-27 fix: flank spline starts at the base circle when a radial line precedes it
    With a fillet and a radial line between it and the base circle, the flank's
    first point was still moved down to the fillet's end, so the spline doubled
    the radial line. Fixed in GearMath.cs and gearset.py; a chain check over six
    sets finds no gaps, overlaps, reversals or long arcs. Regenerated outputs follow.
    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
2026-10-27 fix: regenerate the seven output sets with the flank starting at the base circle
    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
    [layout_sectionA.dxf, planet.dxf, planet.stl, sun.dxf, sun.stl]
2026-10-27 docs: note the near-coincident mating flanks seen in the assembly with sketches shown
    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
2026-10-27 fix: involute (tip) interference check with automatic tip shortening; rolling check at 72 steps
    The sun-16 set's thin ring internal tips reached 36 um past the planet's
    base-tangent point and dug 40 um into the planet's flank at some phases. Every
    mesh is now checked; a tip past the limit is taken back by the overshoot plus
    0.05 m, with a note and the contact ratio recomputed. Same in C# and Python;
    outlines agree to 1e-13 mm. Regenerated outputs follow.
    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
2026-10-27 fix: regenerate the seven output sets with the tip-interference check
    The sun-16 set gets its thin ring internal tips shortened by 0.086 mm (noted in
    its report, contact ratio 1.75); the rolling check now runs 72 steps and reads
    zero penetration everywhere. The other sets change only in the report's check
    figures.
    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
    [layout_sectionA.dxf, thin_ring_sectionA.dxf, thin_ring_sectionA.stl]
2026-10-27 docs: default set with 0.05 mm backlash verified
    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
2026-10-27 feat(add-in): every profile sketch verified inside SolidWorks before it is extruded
    GearBuilder.VerifySketch compares what SolidWorks holds (segments by type,
    contours and their closure) with what AddOutline drew: the tooth profile must
    be one closed contour plus one per circle, with exactly the expected flank
    splines, fillet arcs, root/tip arcs and radial lines (none on rings). One
    report line per sketch; the message box summarises or lists problems.
    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
2026-10-27 fix(add-in): compile against the real 2020 interop again; CLI prints the sketch report
    Environment is ambiguous with SolidWorks.Interop.sldworks.Environment in AddIn.cs
    and the CLI's Program.cs (now System.Environment); the late-bound Motion Study
    calls need a Microsoft.CSharp reference in both project files. GearSetCli build
    prints every sketch's report line and the summary after the mates.
    Verified on SolidWorks 2020 (2026-10-27) through the CLI, hidden instance: the
    default 1:500 set, 29 sketches checked, 0 problems, every one fixed and fully
    defined, all 14 mates ok. Notes in SESSION-2026-10-25c.md and CLAUDE.md.
2026-10-27 feat: bearings from catalogue parts - NSK 600 series and GOST 60xx, measured once, inserted as real parts
    BearingLibrary (GearBuilder.cs): the .SLDPRT files and folders named (default: the
    NSK "Minature Ball Bearings 600 Series" configured part and the GOST 8338-75 folder
    under C:\HARDWARE AND MORE\Bearings) are opened once in SolidWorks and every
    configuration measured - bore axis and width from the bounding box, OD from the two
    equal extents, bore from the smallest cylindrical face on the axis - and cached under
    %LOCALAPPDATA%\GearSetAddin\bearings. HousingSpec.ForBore(bore, catalogue) takes the
    smallest fitting bore nearest the 60-series size; the builder lays the housing out on
    those bea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
